PittetL02/tpi_carte_electronique_didactique_pittetl02/rpt/photo/Oscilloscope/Bruit_0xA5/00a5d249-485c-46f5-a8fa-445c6b23f5df.jpg

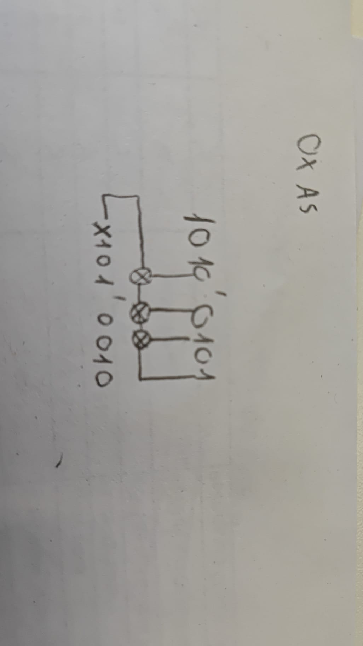
rpt/photo/Oscilloscope/Bruit_0xA5/00a5d249-485c-46f5-a8fa-445c6b23f5df.jpg
