PittetL02/tpi_carte_electronique_didactique_pittetl02/rpt/photo/PCB/V2.0.2/Monté/PCB_Vue_Top.jpg

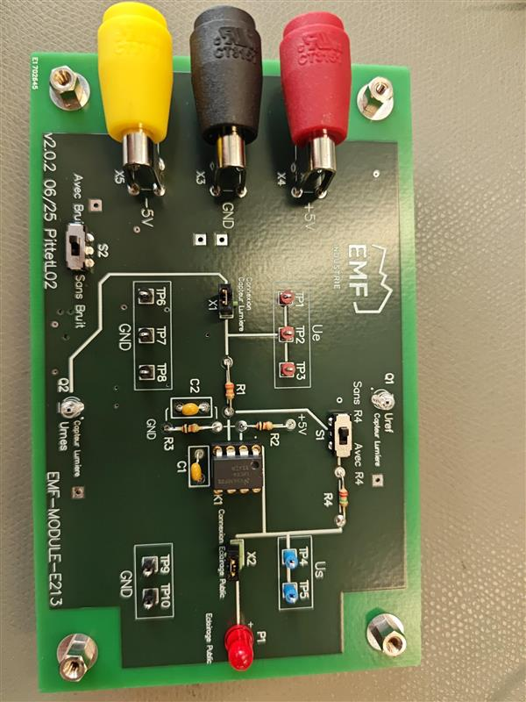
rpt/photo/PCB/V2.0.2/Monté/PCB_Vue_Top.jpg
