PittetL02/tpi_carte_electronique_didactique_pittetl02/pcb/readme.md

# Dossier "pcb"

 Contient toutes les informations nécessaires à la construction du PCB
 Ce dossier est spécialement conçu pour contenir un projet Altium.
 Tous les templates sont dans ce dossier
