PittetL02/tpi_carte_electronique_didactique_pittetl02/pcb/gerber/readme.md

# Dossier "gerber"

 Contient les derniers fichiers gerber créés.
