PittetL02/tpi_carte_electronique_didactique_pittetl02/pcb/pdf/readme.md

# Dossier "pdf"

 Contient les derniers fichiers pdf créés.
 
 example:
 
 projectname-pcb-schematic.pdf
 projectname-pcb-layout-top-implantation.pdf
 projectname-pcb-layout-top-implantation.pdf
