PittetL02/tpi_carte_electronique_didactique_pittetl02/rpt/datasheet/readme.md

# Dossier "datasheet"

 Contient tous les datasheets externes pour la création du projet.
 
 Un datasheet peut être utilisé pour du pcb, pour du fwr, pour du rpt, c'est pourquoi on place les datasheets dans ce répertoire spécifique
