PittetL02/tpi_carte_electronique_didactique_pittetl02/rpt/carte_electronique_didactique_PittetL02-rpt-development.docx

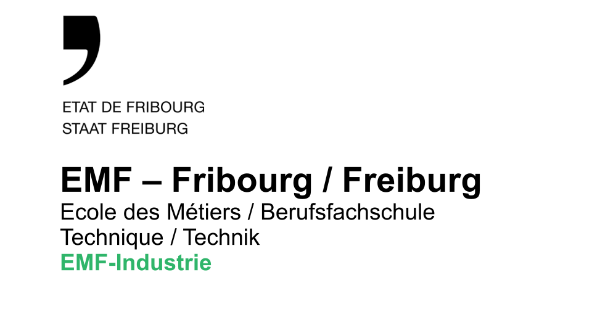
[picture p3: figure]

ELECTRONICIEN/NE CFC
ELEKTRONIKER/IN-EFZ

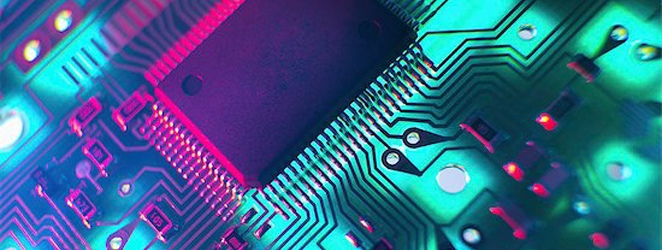
[picture p4: figure]
Le secteur de la technologie en Bourse

Carte Electronique Didactique

1.0.2

Module E213

Métier, Beruf

Pittet Loïc

2024/2025

EMF - Ecole des Metiers de Fribourg

SWITZERLAND

# Table des matières

# 1 Information

## 1.1 Objectifs du projet

Le but du projet est de réalisé un PCB qui met en valeur l’effet de l’hystérèse sur un comparateur en prenant en compte une tension d’entrée variable grâce à un capteur analogique de lumière pour pouvoir voir si l’on doit allumer une LED (éclairage public) s’il y’a trop peu de lumière. Un bruit sera généré avec un PIC.

### 1.1.1 Résumé du cahier des charges

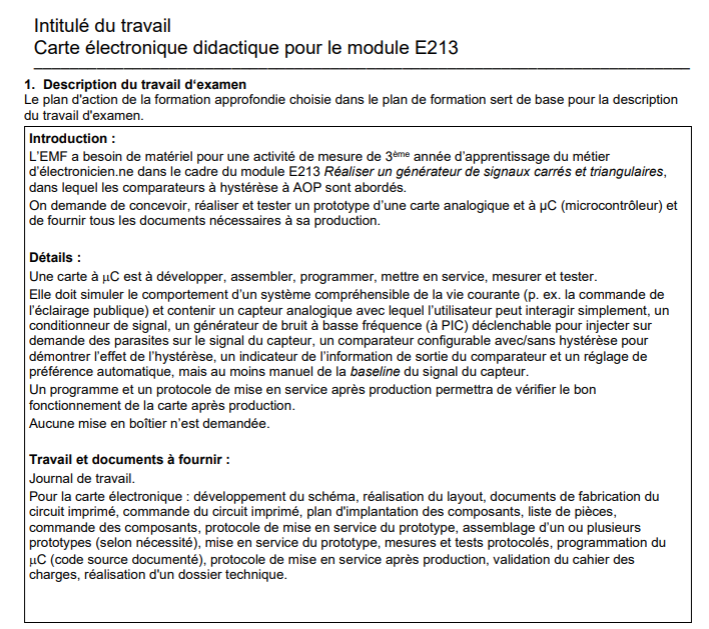
[picture p5: figure]

# 2 Planification

## 2.1 Calendrier prévisionnelle des tâches à réaliser

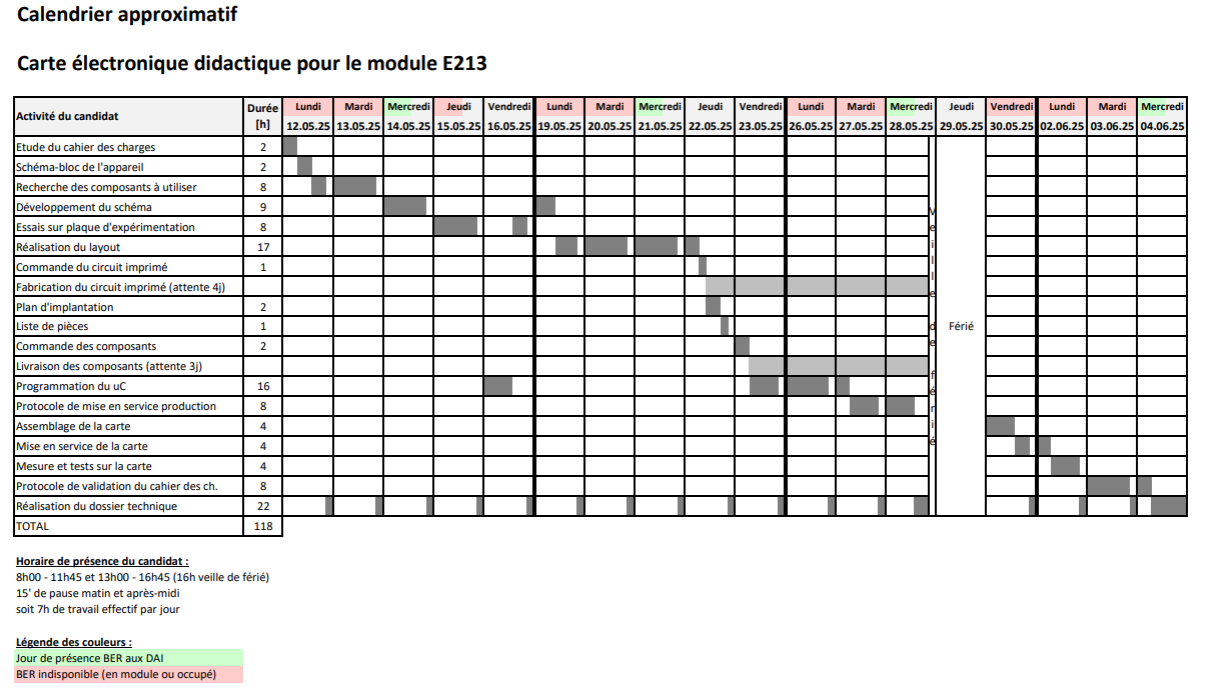
[picture p6: figure]

## 2.2 Calendrier réel des tâches réalisées

# 3 Décision

Date | Qui | Quoi | Pourquoi
13.05.2025 | Pittet | Changer de capteur de lumière. - SFH-3310_EN | Capteur actuel plus disponible sur le marché avant 18 semaines… Les LDRs sont fabriqué avec du Cadmium qui est très polluant.
14.05.2025 | Pittet | Choix du moyen de faire du Bruit avec le PIC. → Bruit numérique par pseudo-aléatoire (LSFR) | Méthode la plus simple à mettre en place sans rajouter trop de composants.
14.05.2025 | Pittet, Berset | Choix du PIC. - PIC16F15214 | Pic déjà connu dans l’entreprise et il n’a pas trop d’I/O. On a besoin que d’une seule sortie.
14.05.2025 | Berset, Pittet | Mettre un deuxième capteur de lumière | Avoir une tension de référence fixe qui ne sera jamais plus grande que celle que l’on mesure. (Moins il y’a de lumière, plus la tension baisse)
15.05.2025 | Berset, Pittet | Ajout d’un filtre passe-bas | Passer d’un signal carré en sortie du PIC en un signal plus rond après le filtre. Cela rend le scintillement plus réaliste.
16.05.2025 | Berset, Pittet | Inverser les tensions à soustraire. | Avoir une tension positive à la sortie de l’additionneur inverseur pour avoir une tension positive en entrée du comparateur.
16.05.2025 | Pittet | Changement résistance en série du capteur de lumière 6k8 → 10k | Réajustement de la résistance pour le nouveau capteur de lumière.

# 4 Réalisation

## 4.1 Schéma bloc de l'électronique à développer

Le schéma bloc nous sert à mieux comprendre l’idée de base au début d’un projet. On peut y voir directement quels sont les groupes de fonctions qui sont importants dans le fonctionnement du circuit.

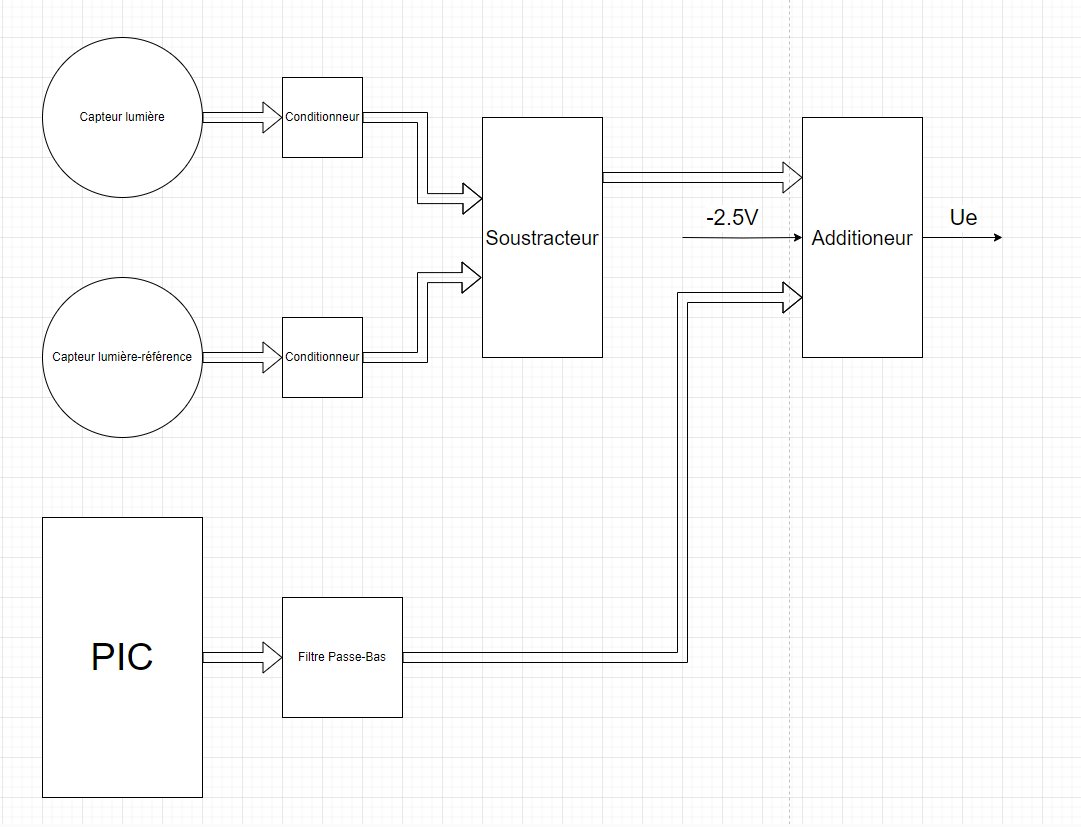
[picture p7: figure]

Le but de ce circuit est d’avoir une tension utilisable variable pour pouvoir l’utilisé comme tension comparatif à 2,5V. Pour ce faire, nous pouvons voir le conditionneur qui précède cette tension. Nous allons générer un petit bruit d’environ 20mV.

La première partie est constitué de deux capteurs de lumières (phototransistor). Un premier capteur est là pour avoir une tension de référence qui ne changera jamais (à part si un nuage vient perturber la lumière ambiante.) Cette tension sera soustraite de l’autre capteur pour que cette tension ne soit jamais positive (à voir après pourquoi). A savoir que si la lumière capté baisse, le courant baisse et en conséquence la tension aussi. Donc si l’on cache ce second capteur, la tension de référence sera de toute façon plus grande. C’est pourquoi que la tension de sortie sera négative ou nulle.

Nous allons ensuite passer cette tension de sortie du soustracteur dans un additionneur inverseur. C’est pourquoi il nous fallait une tension négative après le soustracteur pour pouvoir retrouver une tension positive à la sortie de l’additionneur. A cette tension, nous allons ajouter une composante continue de -2,5V pour pouvoir travailler autour de la tension de seuil qui est de 2.5V au lieu de travailler sur une tension pratiquement nulle.

Et pour terminer, un bruit d’environ 20mV est ajouté au signal pour pouvoir voir l’effet du bruit sur un comparateur avec et sans hystérèse. Ce bruit est généré grâce à la méthode de Bruit Numérique par Pseudo-Aléatoire (LFSR). J’utilise un PIC dans lequel j’ai codé un registre à décalage. Le bit 0,3 et 5 sont récupéré et sont passé dans des portes XOR pour avoir un nouveau bit « aléatoire » sur le 8ème bit. Ce qui nous permet d’avoir un bruit pseudo-aléatoire. Cependant, nous ne pouvons pas traiter cette tension tel quel. C’est pourquoi nous allons créer un filtre passe-bas pour avoir une tension un peu plus analogique et non numérique.

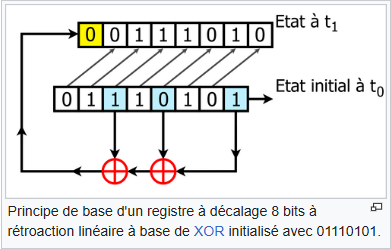
[picture p8: figure]
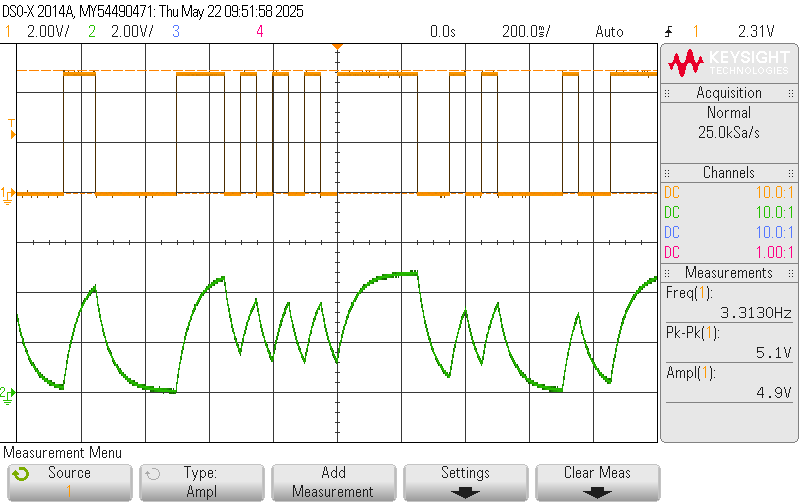
[picture p9: figure]

Le signal orange montre la sortie sur PIC. Nous pouvons observer sur le signal vert la tension filtrée en passe-bas.

Après que ces trois tensions sont additionnées, nous pouvons la traiter dans une entrée de notre comparateur. Nous allons comparer cette tension d’entrée variable à une tension de seuil fixe de 2,5V. Voilà pourquoi nous avions ajouté un offset de 2.5V auparavant.

### 4.1.1 Schéma bloc de l'électronique à développer 2

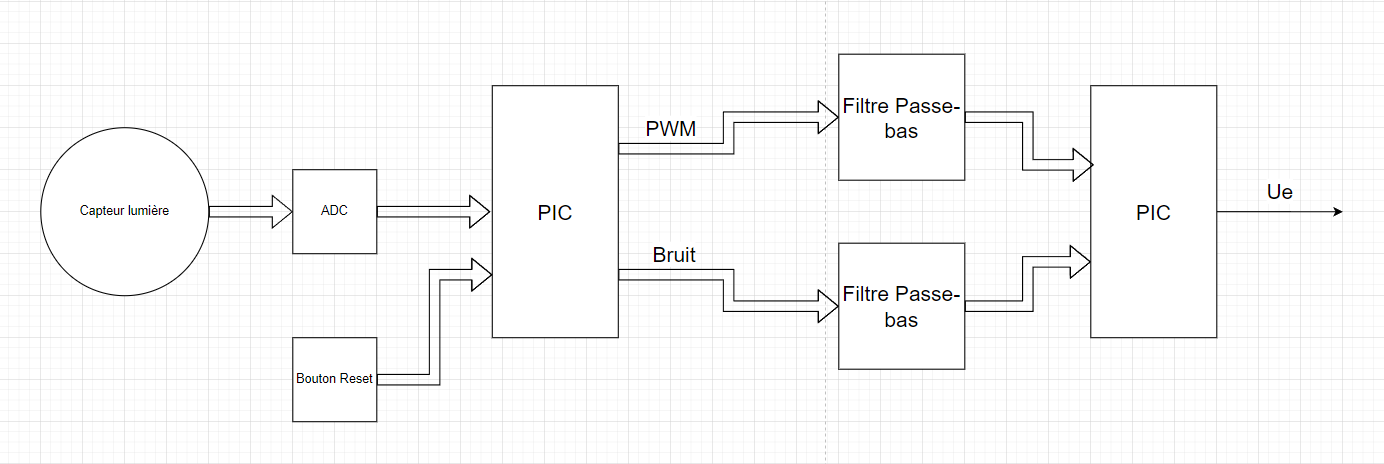
[picture p10: figure]

Cette proposition a été jugé trop compliqué à gérer la partie PWM.

Le but était de reset le programme avec un bouton lorsque la lumière ambiante change. Mais dans un atelier, il y’a du mouvement, des zones d’ombres et s’en parler des perturbations externes tels que les nuages, un coucher de soleil, une lampe…

Cette version avait été imaginer pour que le PIC s’occupe de tout en interne.

### 4.1.2 Schéma bloc de l'électronique à développer 3

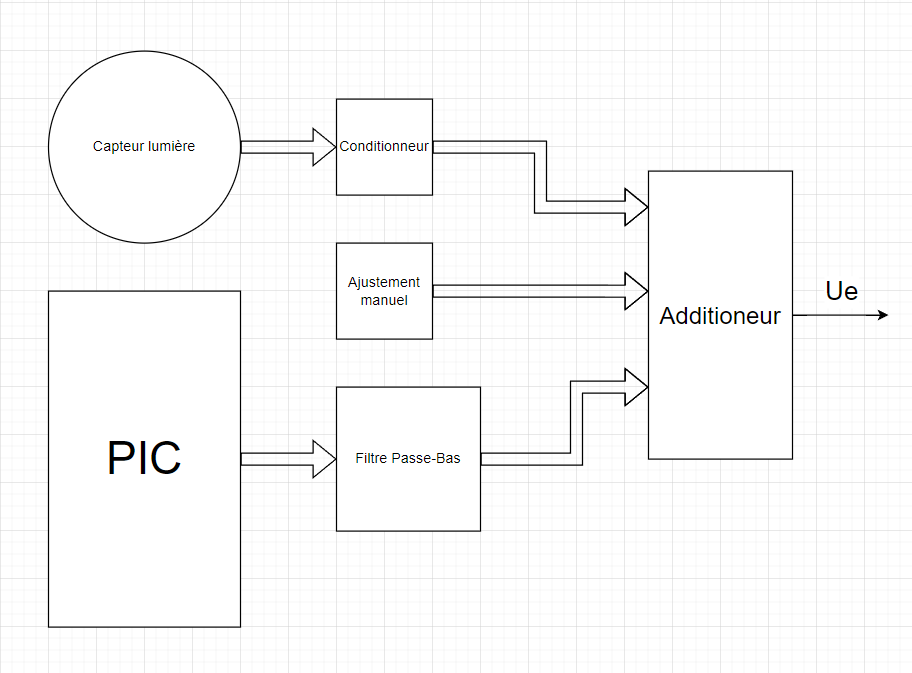
[picture p11: figure]

Solution abordable mais pas très pratique puisqu’à chaque fois qu’un évènement vient perturber la lumière, il faut réajuster la tension (de référence) avec un trimmer (donc manuellement) par exemple la tension de la lumière actuelle. Par exemple lorsqu’un nuage passe devant le soleil, cela va biaiser les mesures. Pareil si quelqu’un éteint la lumière…

Cette solution est un entre deux entre la version PWM et la version choisie.

## 4.2 Schématique, Dimensionnement & simulation

### 4.2.1 Schématique globale

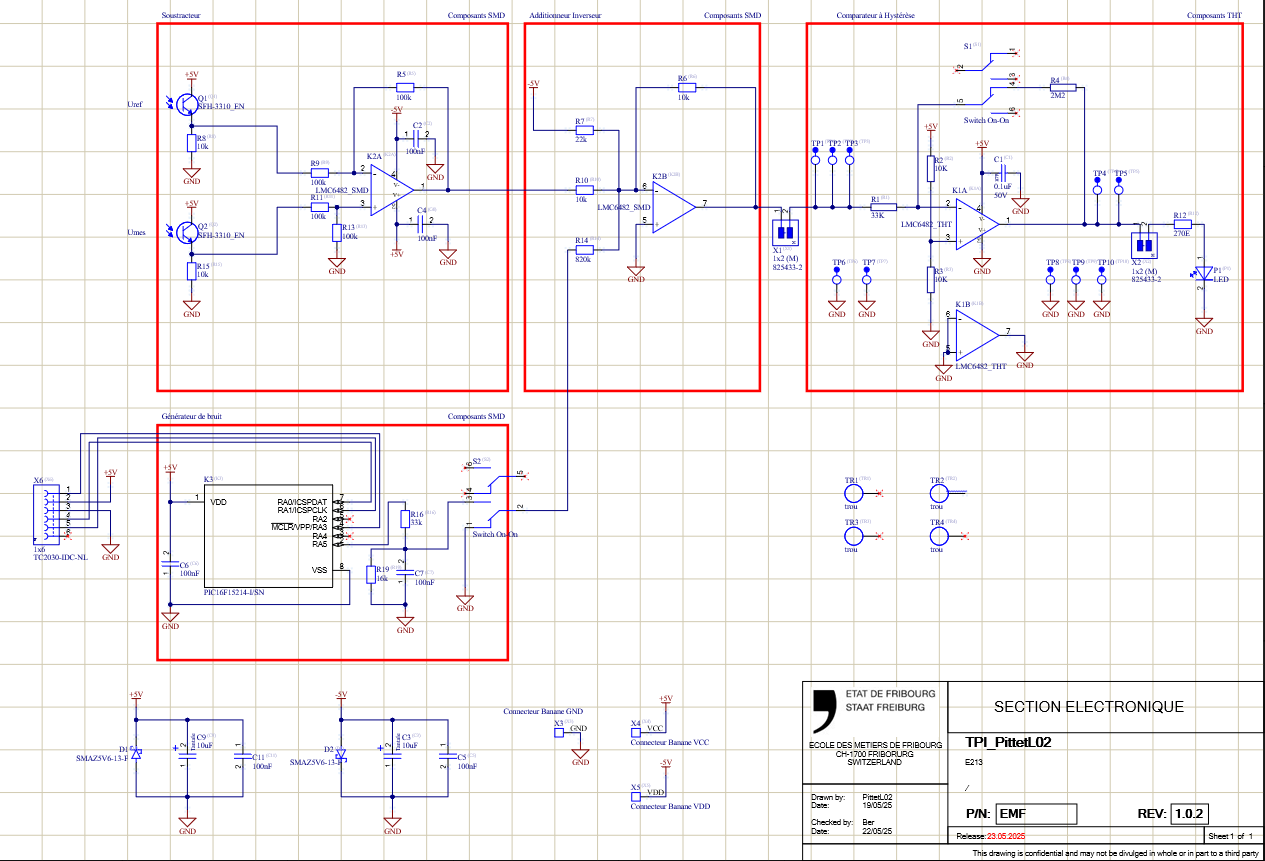
[picture p12: figure]

#### 4.2.1.1 Schématique Soustracteur

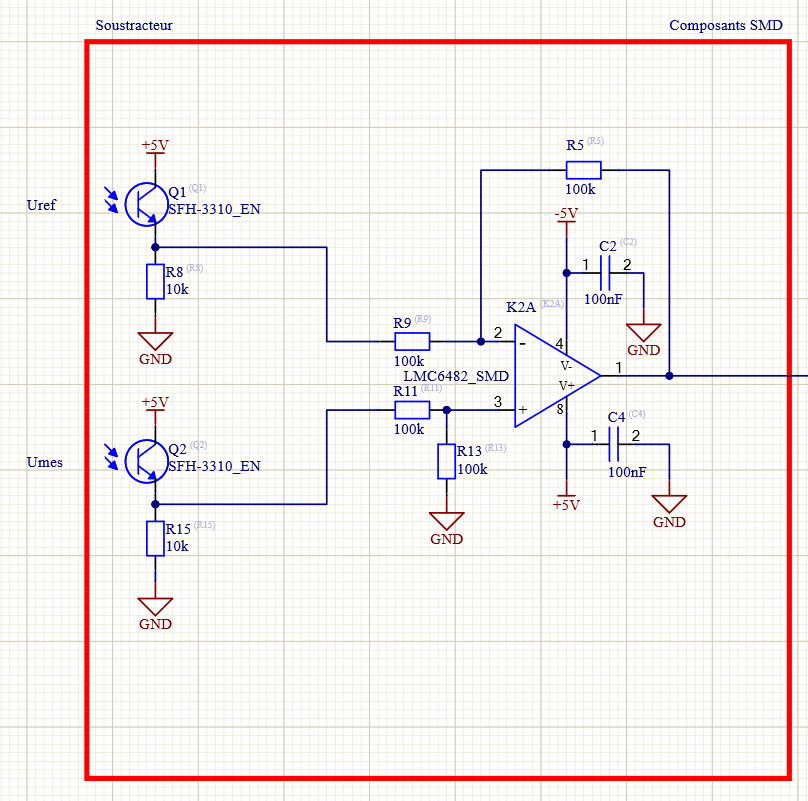
[picture p13: figure]

Voici la première partie de notre schéma. On peut observer que l’on soustrait une tension de référence « fixe » à une tension mesurable (Umes).

Q1 et Q2 sont deux phototransistors qui mesurent l’intensité lumineuse.

Q1 est fixe, c’est-à-dire que l’on ne va jamais modifier la lumière qu’il capte.

Q2 est variable, c’est-à-dire que si l’on vient cacher le capteur de la lumière, le courant va baisser et donc la tension aussi.

On n’a pas besoin d’amplifier le signal donc j’ai dimensionné un gain de 1.

La tension de sortie du soustracteur sera toujours négative ou égal à 0V. Comme on vient que cacher Q2 et que l’on ne va jamais venir ajouter de la lumière dessus, alors la tension de sortie ne sera jamais positive. (voir plus bas avec simulation TINA)

#### 4.2.1.2 Schématique Additionneur

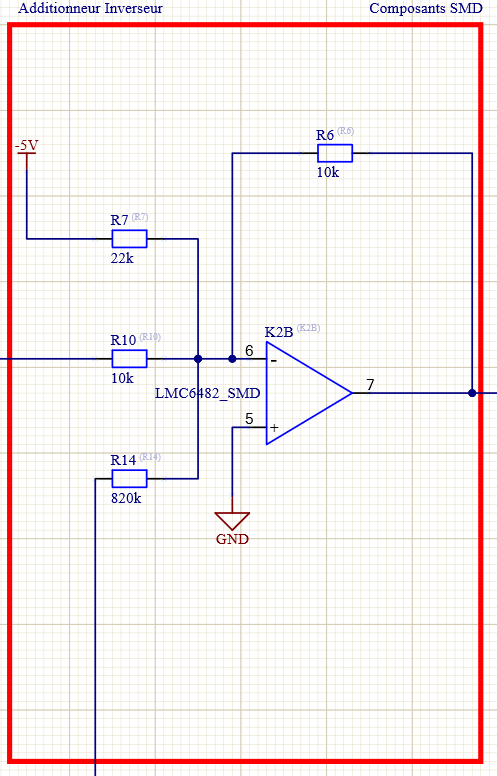
[picture p14: figure]

Voici la deuxième partie du notre schéma. On peut observer que l’on additionne trois tensions. Nous avons la tension de sortie du soustracteur sur R10, une composante continue de -2,5V sur R7 et une dernière tension de 20mV qui est une simulation de bruit.

Le montage est un additionneur inverseur. Voilà pourquoi on voulait une tension négative en sortie du soustracteur. On peut avoir une tension minimale de -2,5V et maximale de 0V sur R10 avec un gain de 1.

Pour générer un offset de 2,5V pour pouvoir travailler autour de la tension de seuil du comparateur qui est de 2.5V, on va additionner une composante continue de -2.5V avec un gain de -0.5V/V (-R6/R7).

La dernière tension additionnée est une tension d’environ 1.6V sur R14 avec un gain de 12mV/V pour avoir une tension de bruit de 20mV (-R6/R14). Cette tension est générée par un PIC (détaillé plus bas).

Nous allons retrouver une tension positive ou égal à 0V en sortie de l’additionneur.

#### 4.2.1.3 Schématique Générateur de bruit

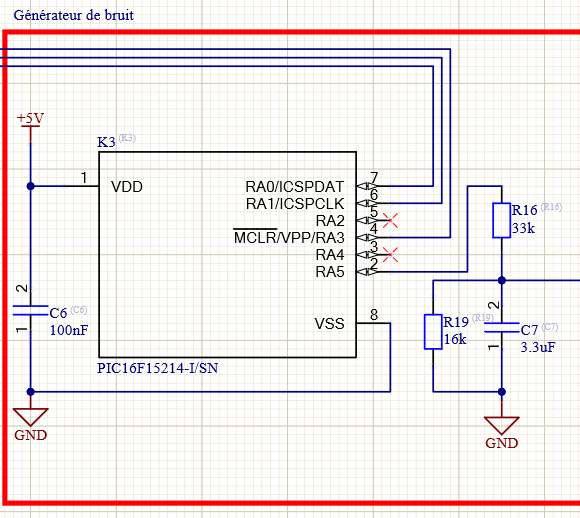
[picture p15: figure]

Voici une partie importante de la schématique. Puisque c’est grâce à ce bruit que toute l’application ait du sens.

Le PIC génère une tension numérique « aléatoire » grâce à un registre à décalage de 8 bits. On ressort le bit 0,3 et 5 que l’on passe dans des portes XOR et l’on remet ce bit en entrée du registre à décalage. Avec ce procédé, on obtient une tension numérique pseudo-aléatoire. Ce qui nous permet de dire que cela est du bruit après avoir filtré cette tension avec C7 pour la rendre analogique.

Le diviseur de tension nous permet de réduire la tension pour éviter d’avoir une résistance R14 (additionneur) trop élevé. On a un peu près une tension de 1.6V sur R14 (5V x (R19/R19+R16)).

#### 4.2.1.4 Schématique Comparateur à Hystérèse

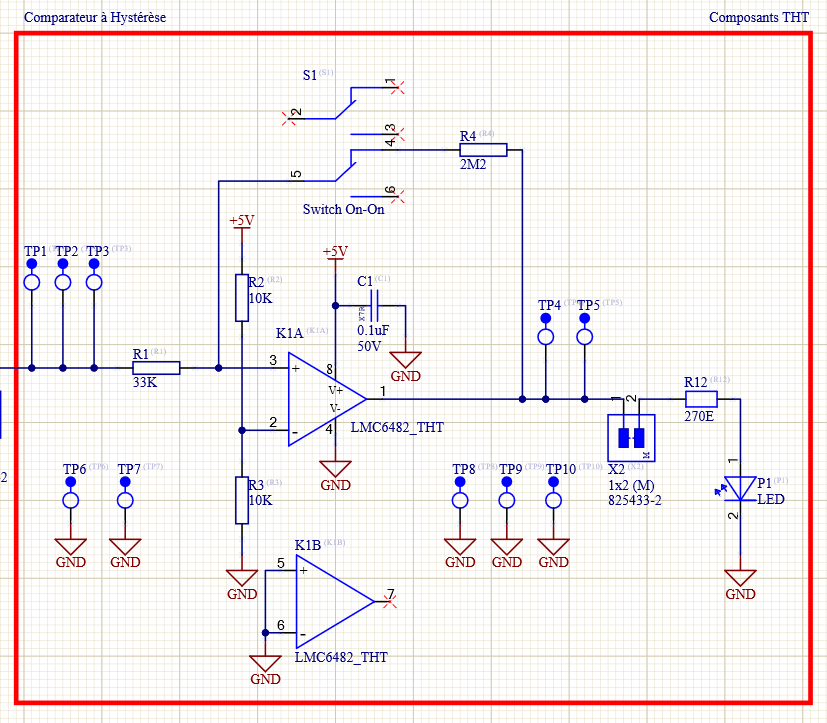
[picture p16: figure]

Cette dernière partie est la partie principale du schéma. Après avoir conditionné le signal avant, on peut enfin venir utiliser cette tension.

On va venir comparer la tension variable conditionné auparavant à une tension fixe de 2.5V (diviseur de tension entre R2 et R3 qui sont identiques).

On a le choix de connecté ou non la résistance R4 (hystérèse) pour pouvoir voir l’effet de celle-ci.

Lorsque la tension d’entrée est plus grande que 2.5V, alors le comparateur va sortir un 1 logique et ainsi 5V en sortie.

Lorsque la tension d’entrée est plus petite que 2.5V, alors le comparateur va sortir un 0 logique et donc 0V.

Pour pouvoir voir l’effet du bruit et de l’hystérèse, on a branché une LED en sortie du comparateur pour pouvoir bien voire quand la LED scintille ou non.

### 4.2.2 Dimensionnement

Pour une tension de 2.5V à lumière ambiante, il faut calculer la résistance à partir d’une autre choisi « aléatoirement ». Dans notre cas, nous mesurons la tensions (à la lumière ambiante) sur une résistance de 6.8kOhms. Nous pouvons ainsi déterminer la résistance pour 2.5V.

Dimensionnement Résistance série du capteur de lumière :

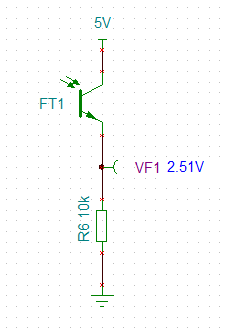
[picture p17: figure]
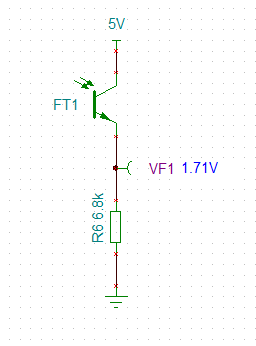
[picture p18: figure]
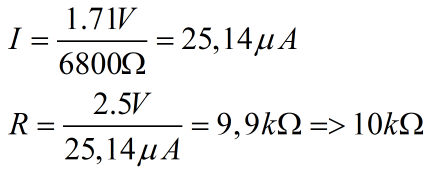
[picture p19: figure]
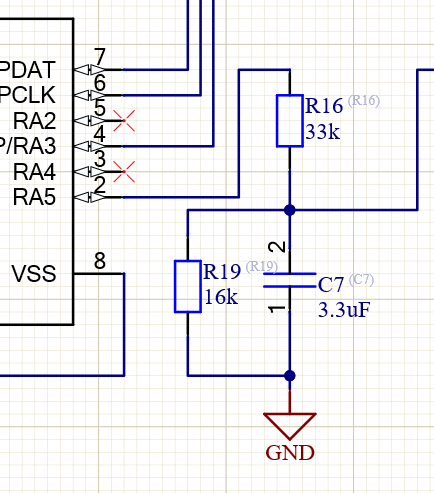
[picture p20: figure]

Dimensionnement Résistance de Bruit :

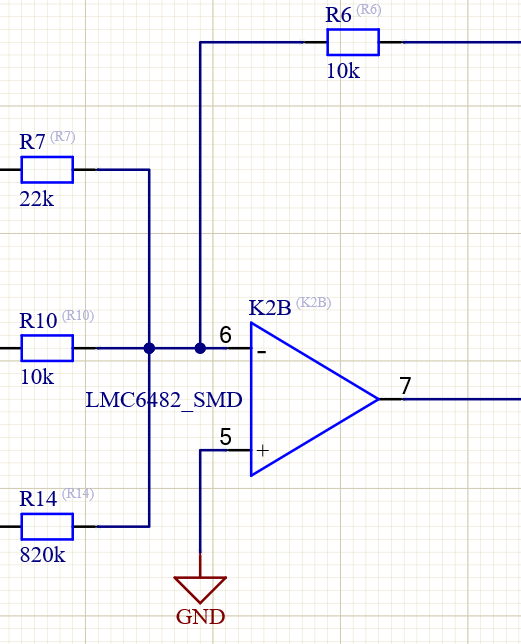
[picture p21: figure]
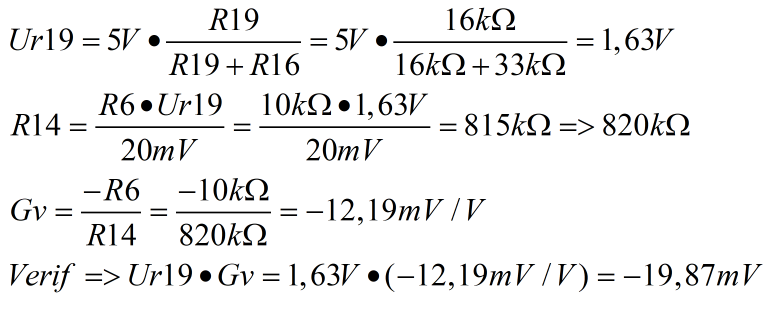
[picture p22: figure]

Le but de ce diviseur de tension entre R16 et R19 est d’abaisser la tension pour ensuite pouvoir abaisser la valeur de R14 et éviter qu’elle soit trop grande.

Dimensionnement Condensateur du filtre passe-bas :

Pour une fréquence de coupure d’environ 50Hz et une résistance de 50kOhms mesuré sur plaque d’essais (Potentiomètre en série avec le condo pour pouvoir ajuster au mieux ) :

Après test, la constante de temps est jugée trop courte.

→x10 sur C →680nF

Il faut réajuster le condensateur pour garder la même constance de temps avec les nouvelles résistances.

Pour le soustracteur, nous avons besoin d’un gain de 1V/V

C’est pourquoi nous avons les mêmes valeurs de résistances pour R5,R9,R11 et R13.

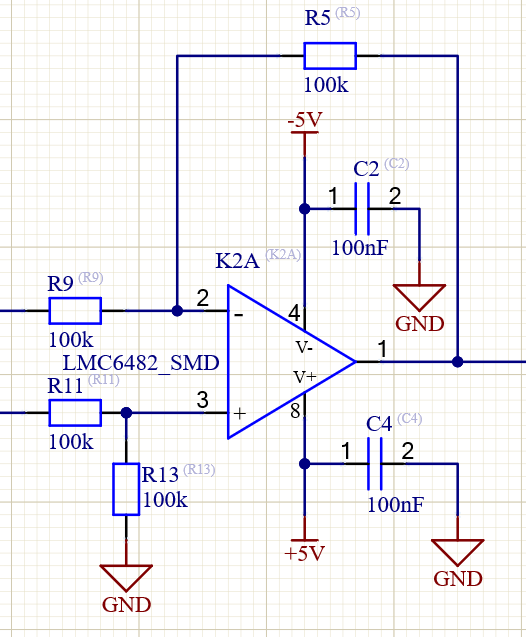
[picture p23: figure]

#### 4.2.2.1 Estimation du courant de consommation du système

A lumière ambiante :

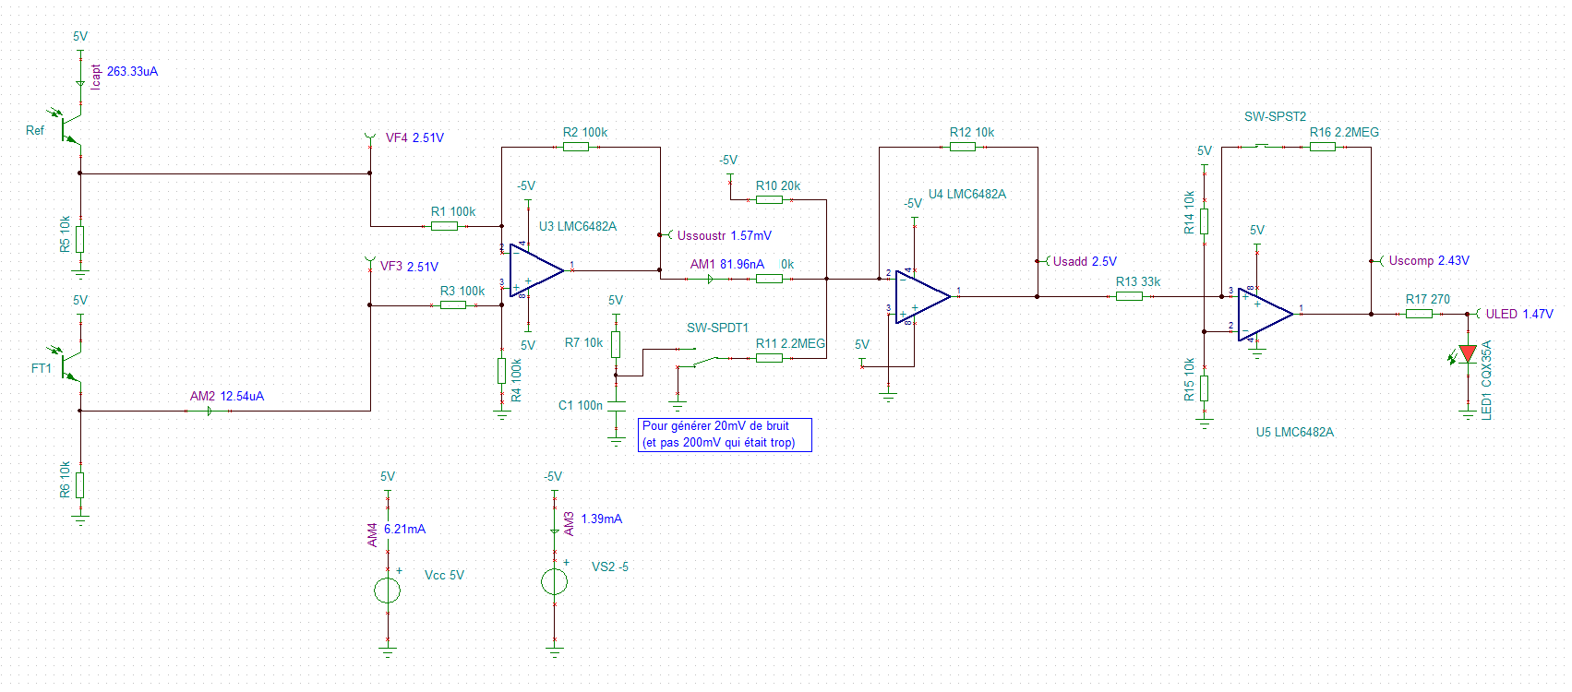
[picture p24: figure]

A lumière maximale :

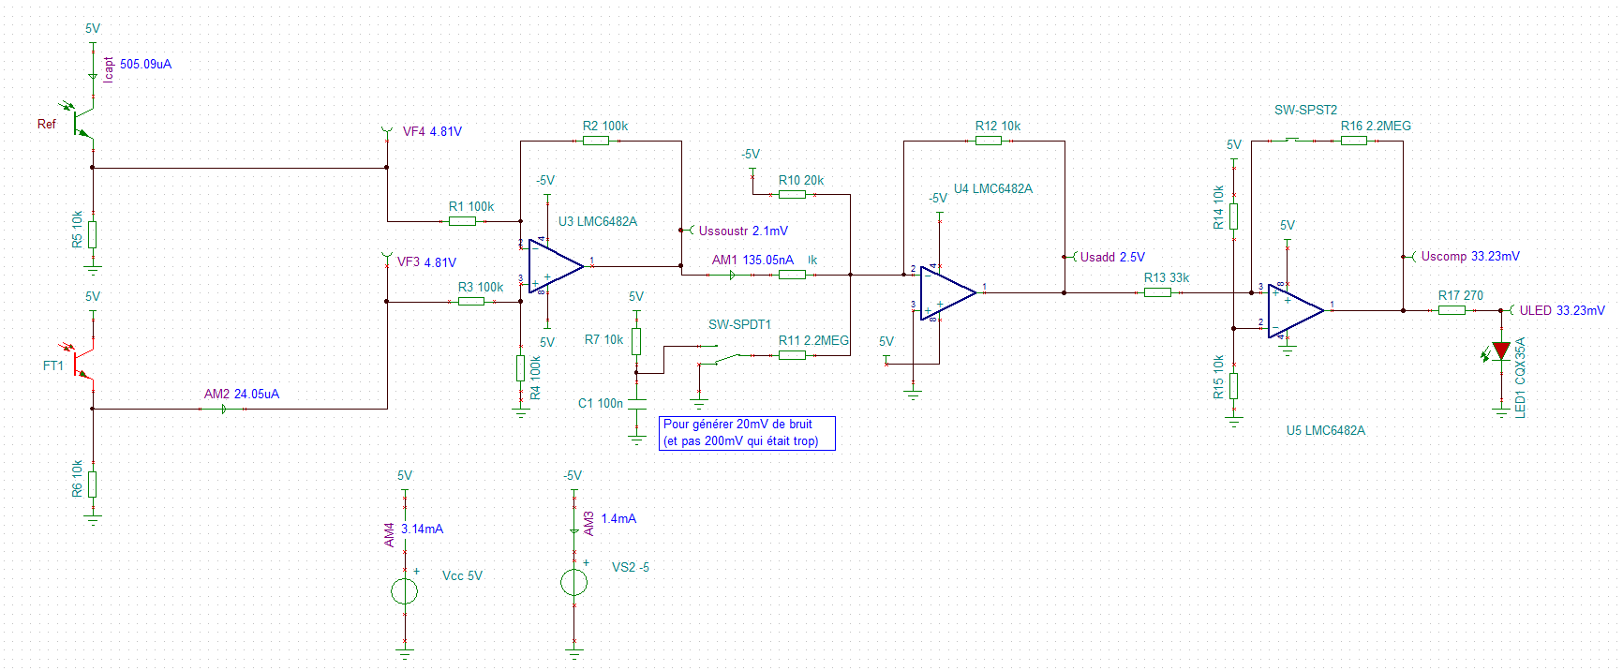
[picture p25: figure]

A lumière minimale :

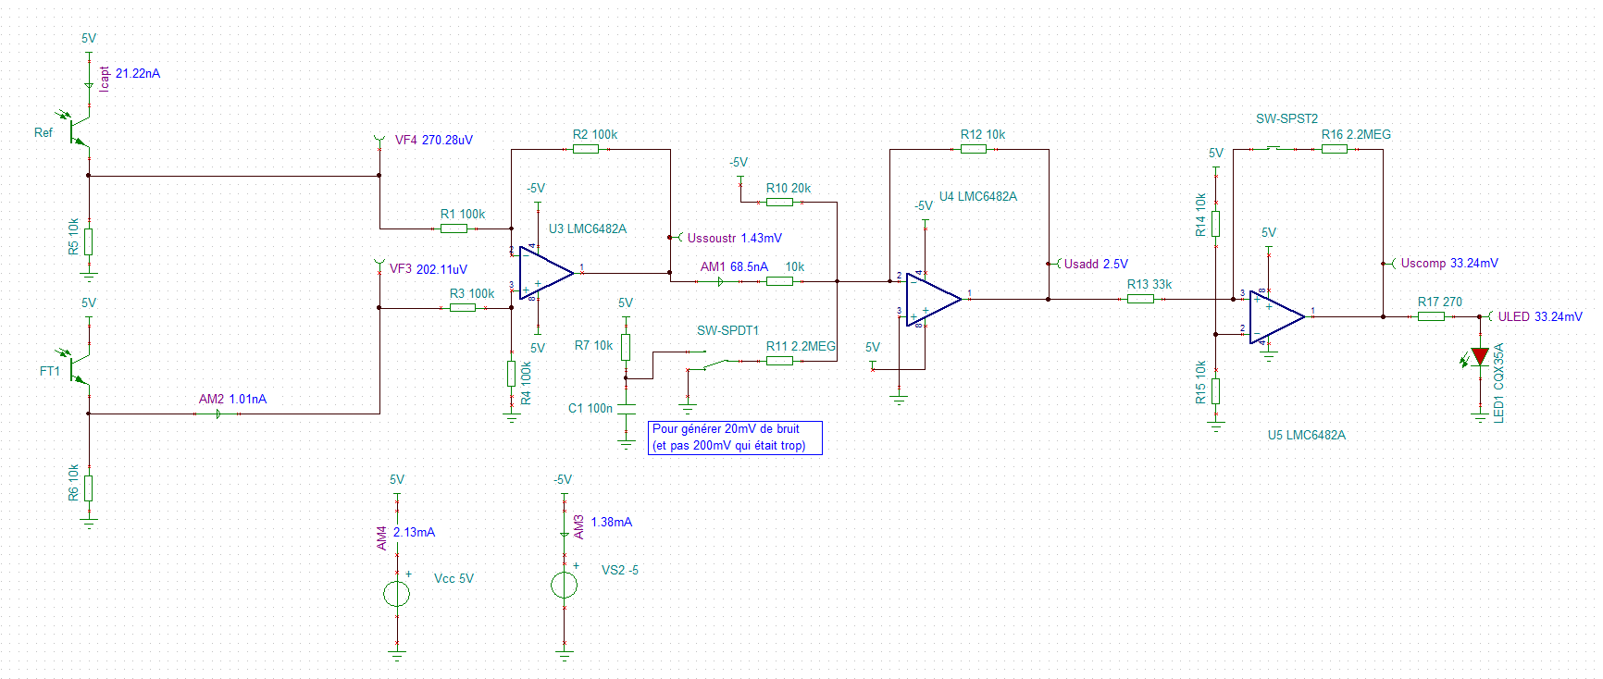
[picture p26: figure]

## 4.3 Rédaction du protocole de mise en service du prototype

### 4.3.1 Protocole de mise en service

Etape | Quoi faire | Valeur attendue | Valeur mesurée | Erreur | Validée | Mes. Ref.
1 | Implanter les connecteurs d’alimentations Mesurer les tensions d’alimentations aux différents endroits dans le pcb (connexions d’alimentation sur ICs, PIC) … | - +5V -5V | - | - | | -
2 | Implanter les condensateurs de découplages et la diode de protection Mesurer les tensions d’alimentations | +5V -5V | | …%
3 | Implanter le bloc Soustracteur Mesurer la tension d’entrée et de sortie du bloc | Ue = ~2.5V Us =~0V
4 | Implanter le bloc Additionneur Inverseur Mesurer la tension d’entrée et de sortie du bloc | - Ue = ~0V Us = ~2,5V | - | - | | -
5 | Implanter le bloc Générateur de bruit Mesurer la tension de sortie du bloc | Us = ~1,6V
6 | Implanter le bloc Comparateur à Hystérèse Mesurer la tension d’entrée et de sortie du bloc Mesurer la tension sur la PIN 2 | Ue = ~2.5V Us = ~0V ~2.5V
7 | Mesure tension d’entrée et de sortie du comparateur avec Q2 complètement dans le noir | Ue = ~5V Us = ~5V
8 | Mesure tension d’entrée et de sortie du comparateur avec Q2 un peu caché | 5V > Ue > 2.5V Us = ~5V
9 | Mesure du courant d’entrée à lumière ambiante | Ie+ = ~6.2mA Ie- = ~-1.39mA

### 4.3.2 Mesure1

#### 4.3.2.1 But de la mesure

#### 4.3.2.2 Schéma de mesure

#### 4.3.2.3 Liste des composants

#### 4.3.2.4 Liste des instruments et leurs réglages

#### 4.3.2.5 Tableaux des valeurs mesurées

### 4.3.3 Mesure2

#### 4.3.3.1 But de la mesure

#### 4.3.3.2 Schéma de mesure

#### 4.3.3.3 Liste des composants

#### 4.3.3.4 Liste des instruments et leurs réglages

#### 4.3.3.5 Tableaux des valeurs mesurées

## 4.4 Liste de matériel

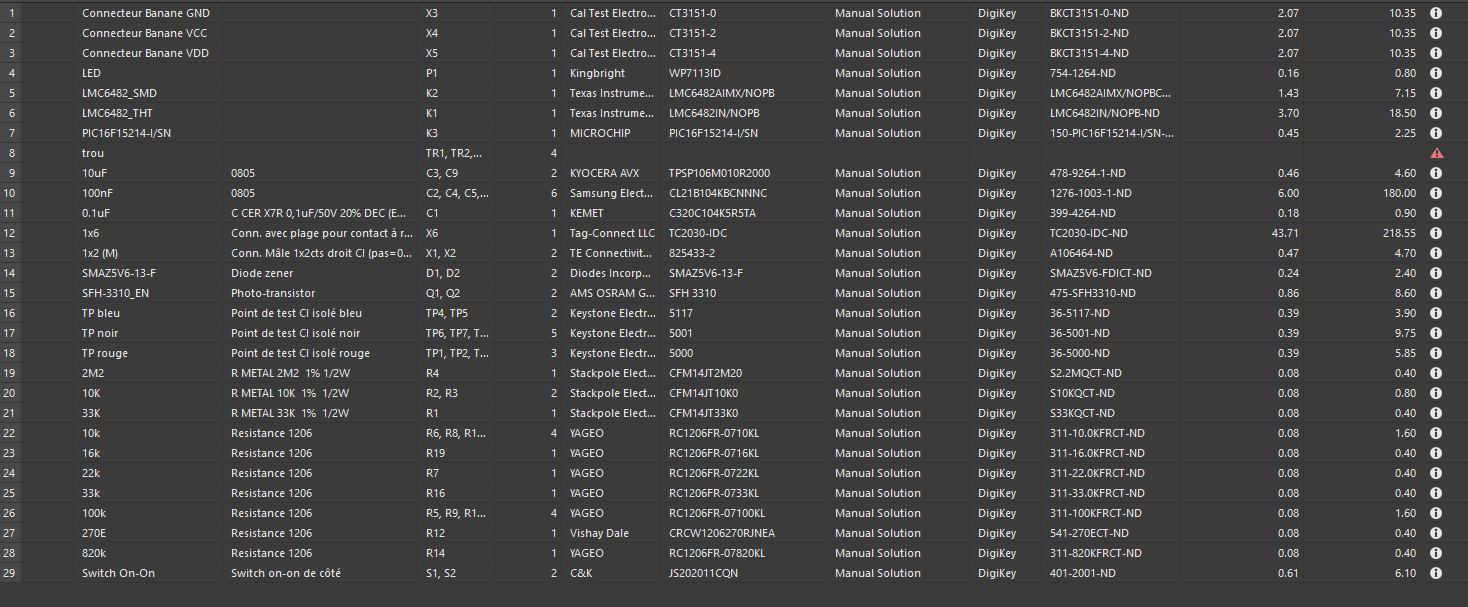
[picture p27: figure]

## 4.5 Layout

### 4.5.1 Contraintes (Rules Check)

J’ai essayé de mettre une clearance la plus grande possible. Malheureusement, comme il y’a des ICs sur le PCB, il n’est pas possible de faire plus grand que 0.2mm sinon les pads de l’IC vont crier lors du DRC.

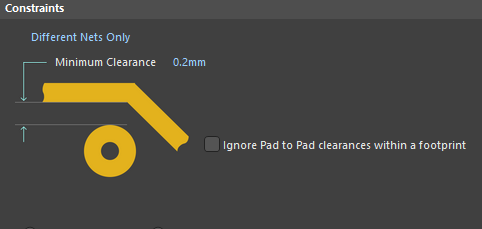
[picture p28: figure]
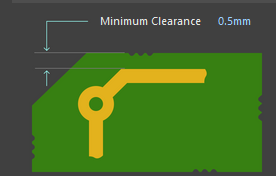
[picture p29: figure]

J’ai défini une BoardOutlineClearance de 0.5mm pour éviter de positionner des composants trop proches du bord. C’est une sécurité pour éviter d’avoir des dommages dû à la fraise de découpage.

#### 4.5.1.1 Largeurs des pistes de cuivre

Pour la largeur de piste, j’ai mis une largeur de piste assez grande (0.762mm) pour les pistes d’alimentation tel que le -5V et le GND. Pour le reste des pistes, elles ont une largeur de 0.4mm. Ces pistes sont normalement assez grandes pour pouvoir accueillir au maximum 10mA.

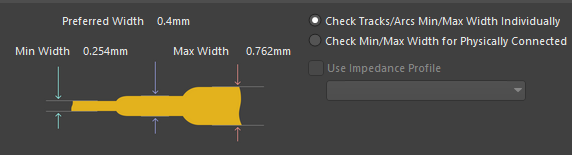
[picture p30: figure]

#### 4.5.1.2 Diamètres des vias

Comme nous avons des pistes maximales de 0.762mm, on ne peut pas mettre de vias de diamètre plus petit. C’est pourquoi j’ai décidé de mettre des vias de diamètre 1mm pour avoir de bonnes connexions. Sur Altium, les vias sont configuré de base avec des freins thermiques. Je l’ai enlevé pour avoir une meilleure connexion.

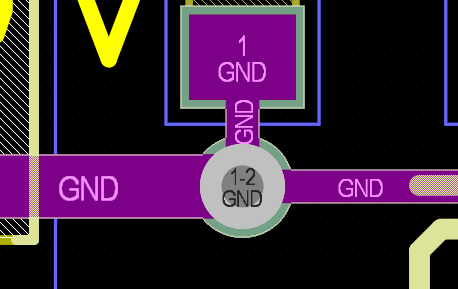
[picture p31: figure]

### 4.5.2 Empreintes spécifiques

#### 4.5.2.1 Connecteur d’alimentation

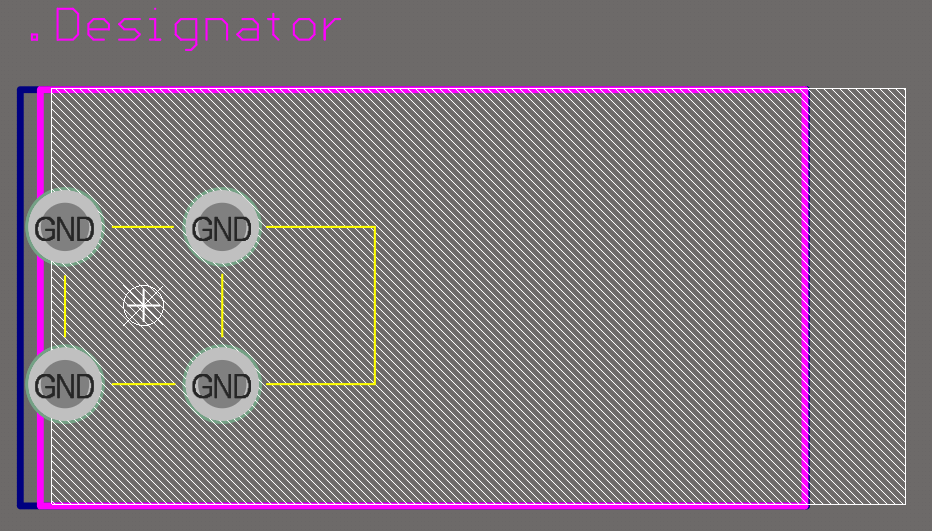
[picture p32: figure]
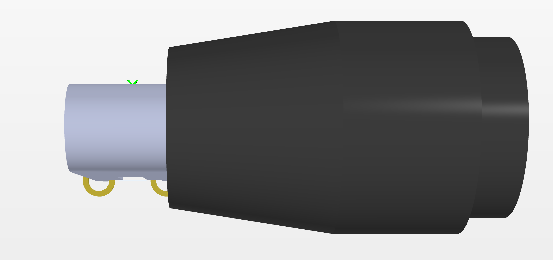
[picture p33: figure]

Cette empreinte est un connecteur banane pour pouvoir facilement brancher les alimentations. Il y’en 1 en noir pour le GND, un rouge pour le +5V et un jaune pour le -5V.

#### 4.5.2.2 AOP LMC6482_SMD/THT

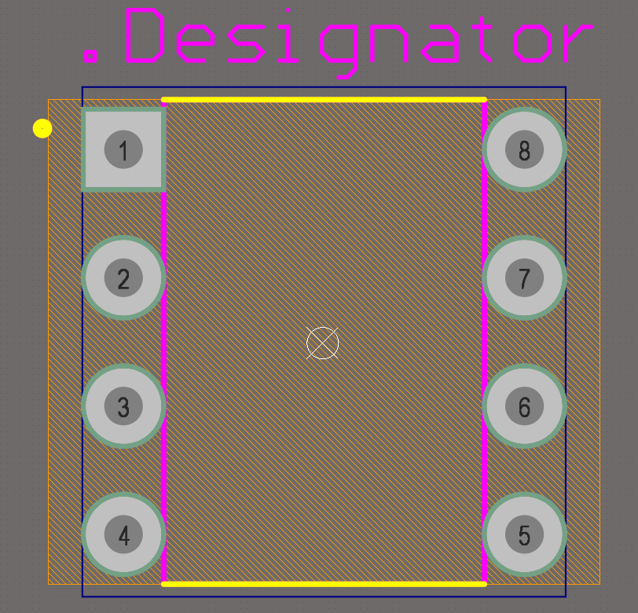
[picture p34: figure]
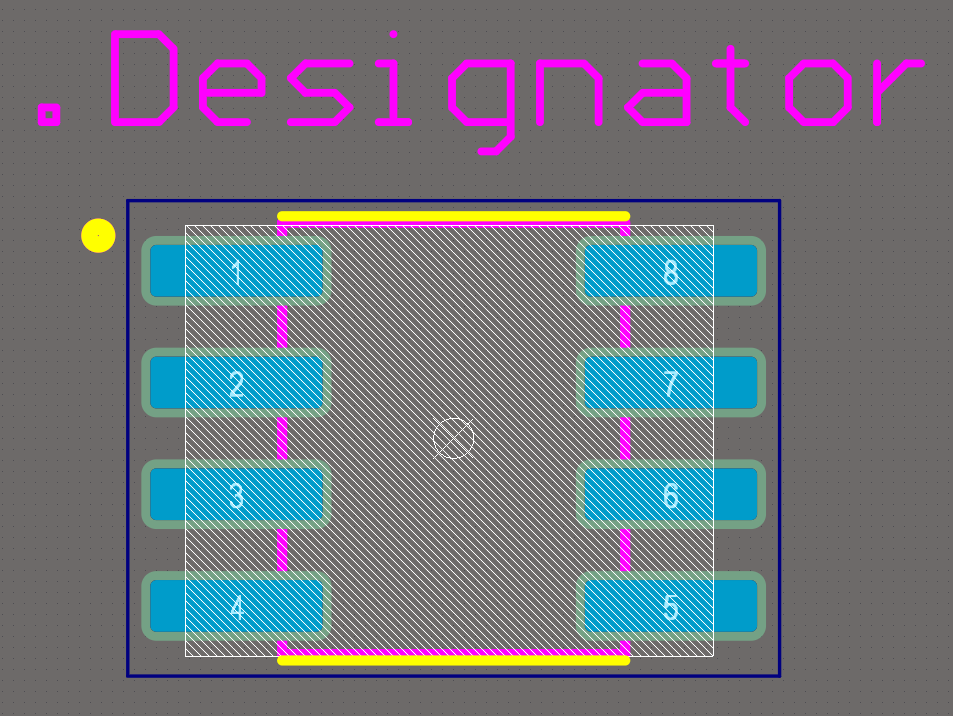
[picture p35: figure]

Dans le projet, nous utilisons plusieurs AOP que ce soit comme soustracteur, additionneur ou encore comme comparateur, cela en fait 3. Nous avons donc choisi d’utiliser 2 ICs dual. Le comparateur est sur la version THT pour que les apprentis puissent le manipuler / le voir sur le TOP. Et le soustracteur ainsi que l’additionneur sont sur une version SMD qui sera présente sur le BOT car ceci représente le conditionneur, chose que les apprentis n’ont pas besoin de voir sur la couche TOP.

#### 4.5.2.3 Phototransistor : SFH-3310

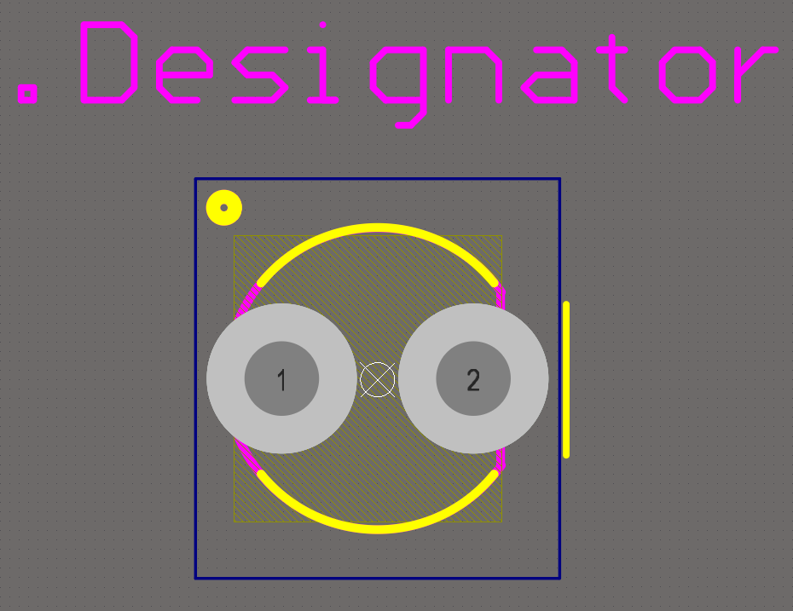
[picture p36: figure]
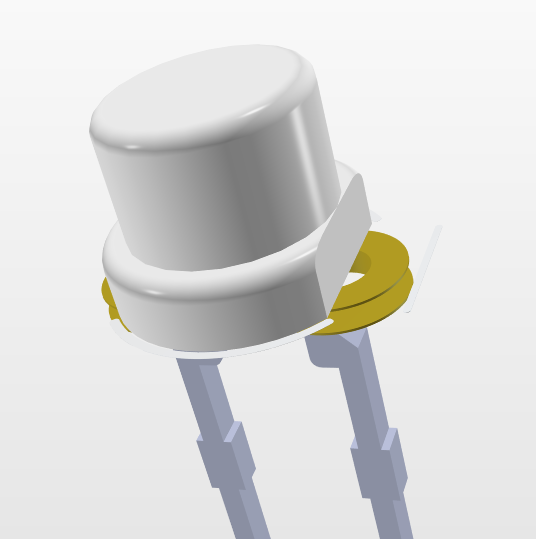
[picture p37: figure]

Voici l’empreinte du capteur de lumière (phototransistor). Il faut faire attention à la polarité.

#### 4.5.2.4 Microcontrôleur

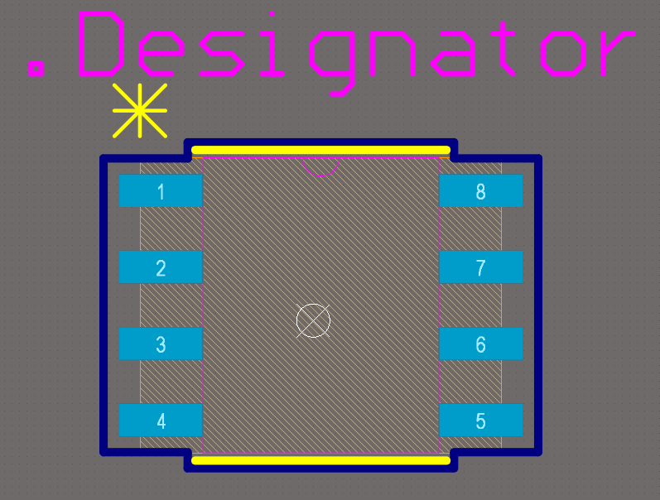
[picture p38: figure]
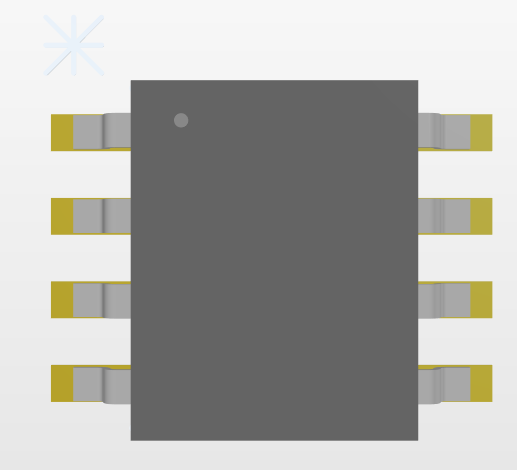
[picture p39: figure]
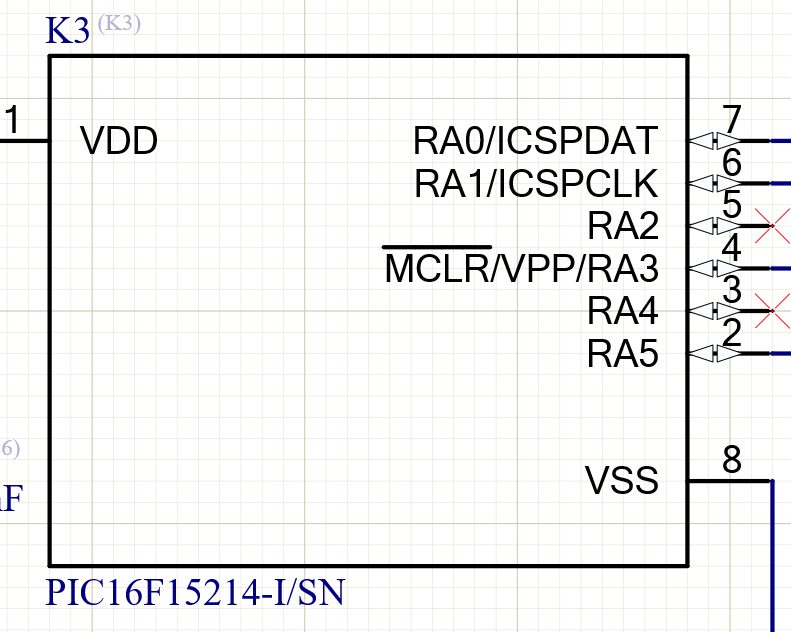
[picture p40: figure]

Nous utilisons le PIC 16F15214-I/SN parce que nous avons très peu d’I/O (un seul). Donc pas nécessaire de prendre un PIC trop grand inutilement. Sur le PIC, nous avons les connexions pour le connecteur de programmation soit : ICSPDAT sur RA0 (Pin 7), ICSPCLK sur RA1 (Pin 6), MCLR sur RA3 (pin 4) et la sortie du PIC sur RA5(Pin 2). Un condensateur de découplage(100nF) a été connecté aux bornes d’alimentations de celui-ci pour lisser la tension et éviter des pics de tensions et donc des surtensions. Nous utilisons ce PIC précisément parce-que nous l’avons déjà employé à l’EMF donc le PIC est connu et déjà testé.

#### 4.5.2.5 Connecteur de programmation

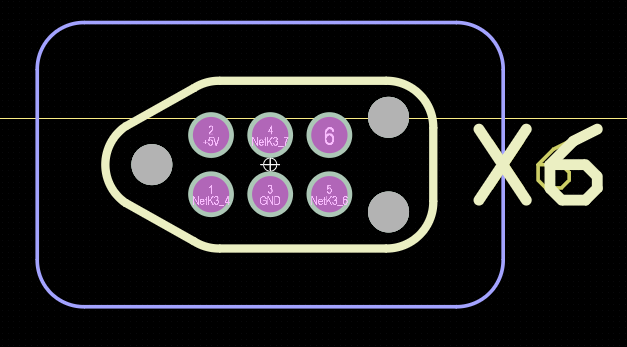
[picture p41: figure]
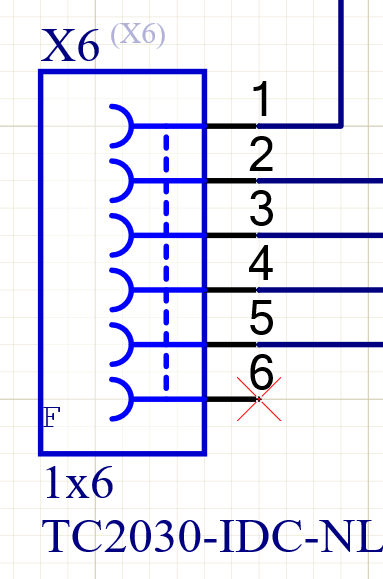
[picture p42: figure]

Ceci est le connecteur de programmation. C’est un connecteur TagConnect assez utile puisqu’après que la programmation ait été implémenter, aucune contrainte mécanique peut venir perturber le PCB. Seul bémol, il faut acheter un câble spécial qui coûte assez cher…

## 4.6 Firmware

uint8_t lfsr = 0xAC; // Seed non nul

void main(void)

{

InitPic();

while (1)

{

uint8_t out = lfsr_next();

LATAbits.LATA0 = out; // Écrit sur RA0

__delay_ms(50); // Ajuster selon le besoin

}

}

uint8_t lfsr_next(void)

{

uint8_t bit = ((lfsr >> 7) ^ (lfsr >> 5) ^ (lfsr >> 4) ^ (lfsr >> 3)) & 1;

lfsr = (lfsr << 1) | bit;

return lfsr & 1; // Renvoie le LSB

}

## 4.7 Phase de production en série

### 4.7.1 Rédaction du protocole de mise en service de post-production

### 4.7.2 Rédaction du mode d’emploi utilisateur

## 4.8 Liste des outils utilisés et leur version

Oscilloscope KEYSIGHT InfiniiVision 2014A EMF-INDU-PHIE-0074

Alimentation DC xantrex XPL-30-2T TRIPLE DC Power Supply EMF-INDU-PHIE-0371

Générateur de fonction Agilent 33250A EMF-INDU-PHIE-0006

Multi-mètre AMPRODE 34XR-A 19100479A

PIC KIT 4 MICROCHIP 10-10094-R1

# 5 Contrôle

## 5.1 Validation ERC

## 5.2 Validation DRC

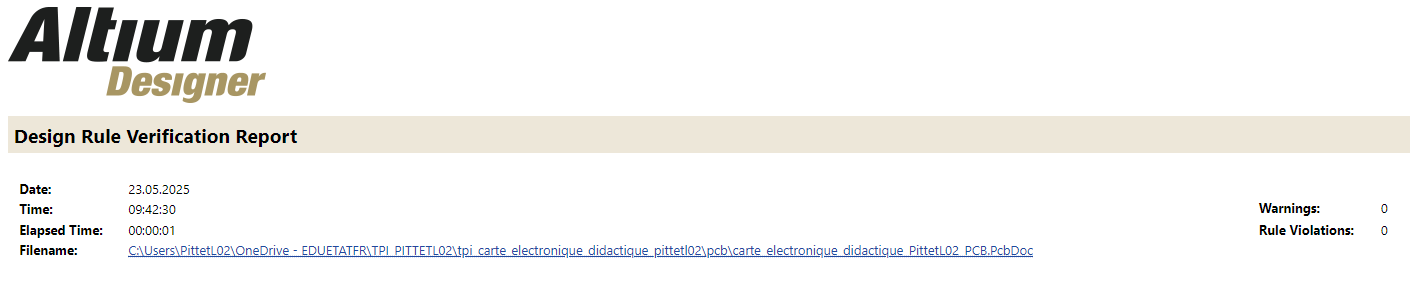
[picture p43: figure]

## 5.3 Validation Eurocircuits

## 5.4 Validation par la mise en service du prototype

# 6 Evaluation

## 6.1 Etat du projet

Fonctionnel

## 6.2 Liste des modifications pour la prochaine version

### 6.2.1 AOP Comparateur

Le comparateur inverseur a été routé à l’envers et est donc devenu un AOP inverseur. Il a donc fallu donc couper les pistes et tirer des fils pour inverser les connexions. Les pins d’alimentations sont donc aussi inversés. Il a fallu inverser ces pins en coupant la PIN du comparateur et tirer des fils pour refaire la connexion correcte.

J’ai aussi mis la sortie du deuxième comparateur à la masse. Ce qui est une grosse erreur. L’AOP va chercher à sortir une tension sur cette sortie, ce que l’on ne veut pas. Il a fallu couper la pin 7 du comparateur.

Ces erreurs ont déjà été corrigées et une nouvelle version des gerbers a déjà été généré.

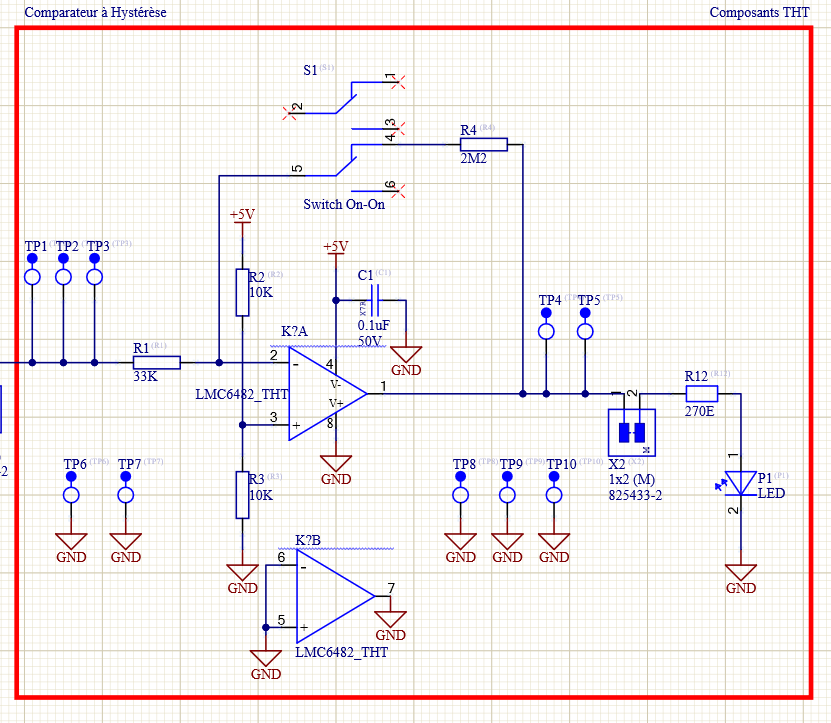
[picture p44: figure]
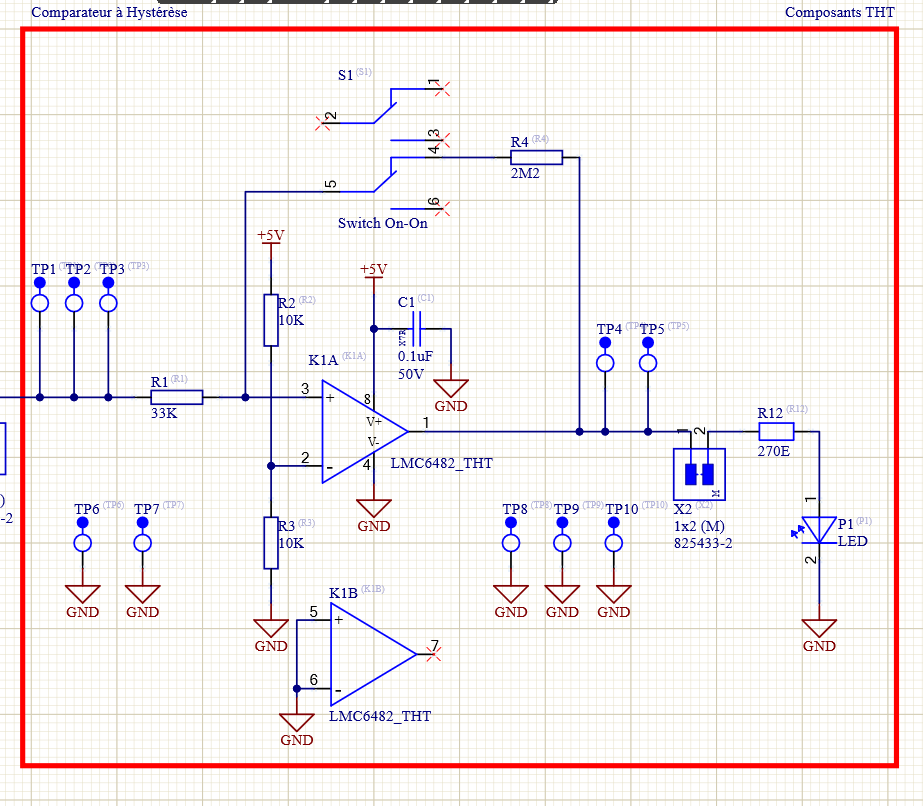
[picture p45: figure]

## 6.3 Liste des délivrables

pcb | Schématique (.pdf)
| Fichier : | projectname-pcb-schema-vx.x.x.pdf | annexé
| Répertoire : | .\projectname\pcb\pdf\
pcb | Plan d’implantation (.pdf)
| Fichier : | projectname-pcb-implantation-bot-vx.x.x.pdf | annexé
| Fichier : | projectname-pcb-implantation-top-vx.x.x.pdf | annexé
| Répertoire : | .\projectname\pcb\pdf\
pcb | Gerber (.zip)
| Fichier : | projectname-pcb-gerber-vx.x.x.zip
| Répertoire : | .\projectname\pcb\
fwr | Firmware (.hex)
| Fichier :
| Répertoire :
swr | Software (.exe)
| Fichier :
| Répertoire :
mec | Plan mécanique (.pdf)
| Fichier :
| Répertoire :
rpt | Liste de matériel (.pdf)
| Fichier : | projectname-pcb-bom-vx.x.x.pdf | annexé
| Répertoire : | .\projectname\pcb\bom\

## 6.4 Amélioration possible

Ajour d’une source lumineuse sur le capteur de référence pour imiter un « soleil » et sur le capteur de mesure pour avoir des capteurs qui ne sont pas perturbé par l’extérieur (nuages, éclairage…). Ajout d’une LED lampadaire pour avoir une application plus réaliste et sympa a utilisé.

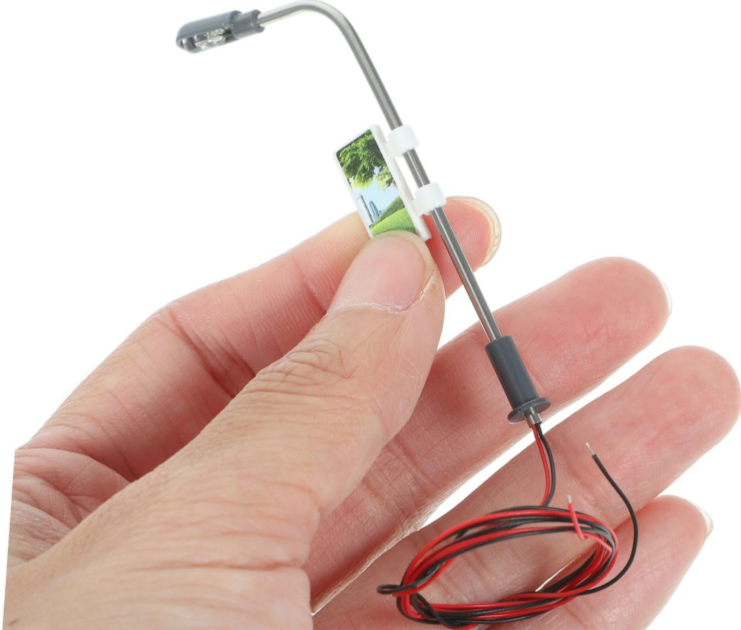
[picture p46: figure]

Ajout d’un petit rail avec un cache coulissant sur le capteur de mesure pour pouvoir plus facilement et plus précisément cacher la lumière et ainsi avoir des valeurs de mesures plus précises.

## 6.5 Conclusion et avis personnel

### 6.5.1 Signatures

Lieu: | EMF, 1705 Fribourg, Switzerland | _________________________
Date: | | myname myfirstname

### 6.5.2 Sources

- https://www.fr.ch/emf

### 6.5.3 Version de ce document

version | date | qui | modification
V1.0.0 | 20210510 | gauchl | Première version

### 6.5.4 Annexes

projectname-rpt-development.docx 4 / 8

EMF: Projet Electronicien CFC Carte Electronique Didactique PittetL02
