PittetL02/tpi_carte_electronique_didactique_pittetl02/rpt/Presentation/carte_electronique_didactique_PittetL02-rpt-presentation.pptx

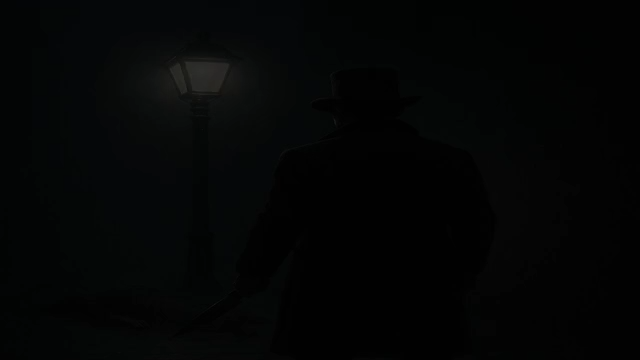
[picture p47: figure]

Notes: Alertes Infos!
Des nouveautés concernant l’affaire Jack The Reaper.
Il aurait été aperçu dans les rues de Londres juste après avoir commis son 5ème meurtre.
Cependant, l’éclairage publique était défaillant en scintillant fortement ce qui a permis au meurtrier de s’enfuir.
Comment un éclairage public peut fonctionner de cette sorte. Comment améliorer ceux-ci pour que sérénité et confiance règne dans les rues le soir et la nuit?
Nous allons voir tout ceci avec une proposition de M.Pittet expert en électronique.

## Carte Electronique didactique pour Module E213

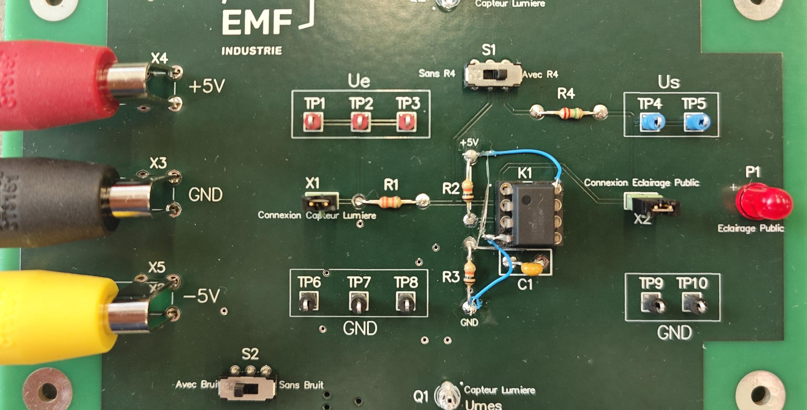
[picture p48: figure]
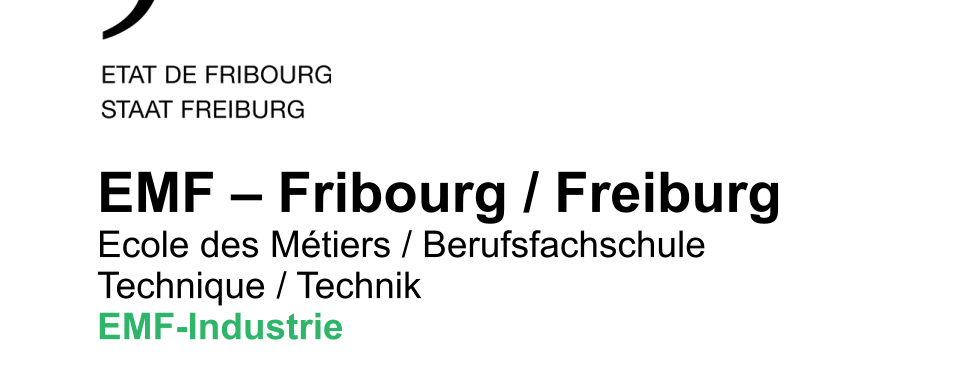
[picture p49: figure]

- EMF / Ecole des Métiers / Berufsfachschule – Fribourg Pittet Loïc Candidat Electrocicien CFC TPI 2024 / 2025

## Déroulement de cette présentation

1. Objectif du projet?
2. Plannification
3. Décision prise lors de ce projet.
4. Réalisation
  1. Schématique
  2. PCB
  3. Firmware
5. Contrôle
6. Evaluation

## 1. Information: Objectifs du projet

Réalisation d’une carte électronique didactique.
Intégrer un capteur analogique.
Simuler un concept de la vie de tous les jours.
Générer du bruit manuellement.

## 1. Information: Tâches à réaliser

Concevoir un conditionneur.
Réaliser du bruit via un uC.
Conception d’une schématique.
Conception d’un PCB.

## 2. Plannification

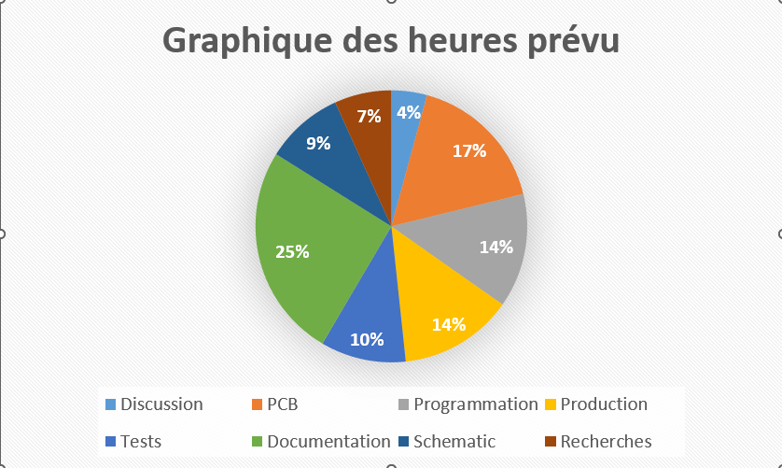
[picture p50: figure]
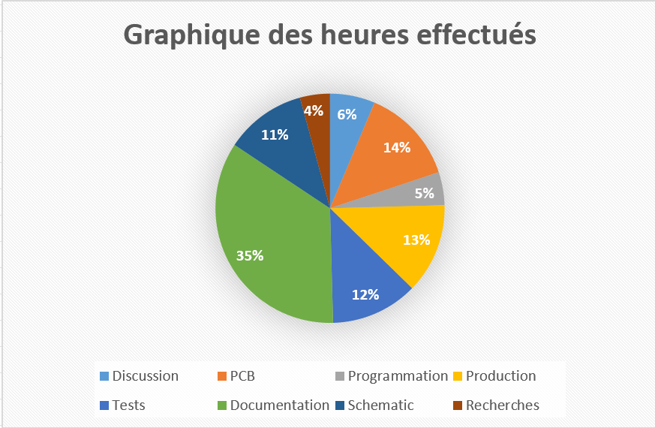
[picture p51: figure]

## 3. Décision: les plus importantes

Changer de capteur de lumière
Méthode pour la génération du bruit
Ajout d’un deuxième capteur.
Inverser la soustraction entre les capteurs

Notes: Capteur lumière : LDRs trop polluant avec du Cadmium.
Bruit : LSFR (Bruit numérique par pseudo-aléatoire) / PWM

## 4. Réalisation: Schéma bloc

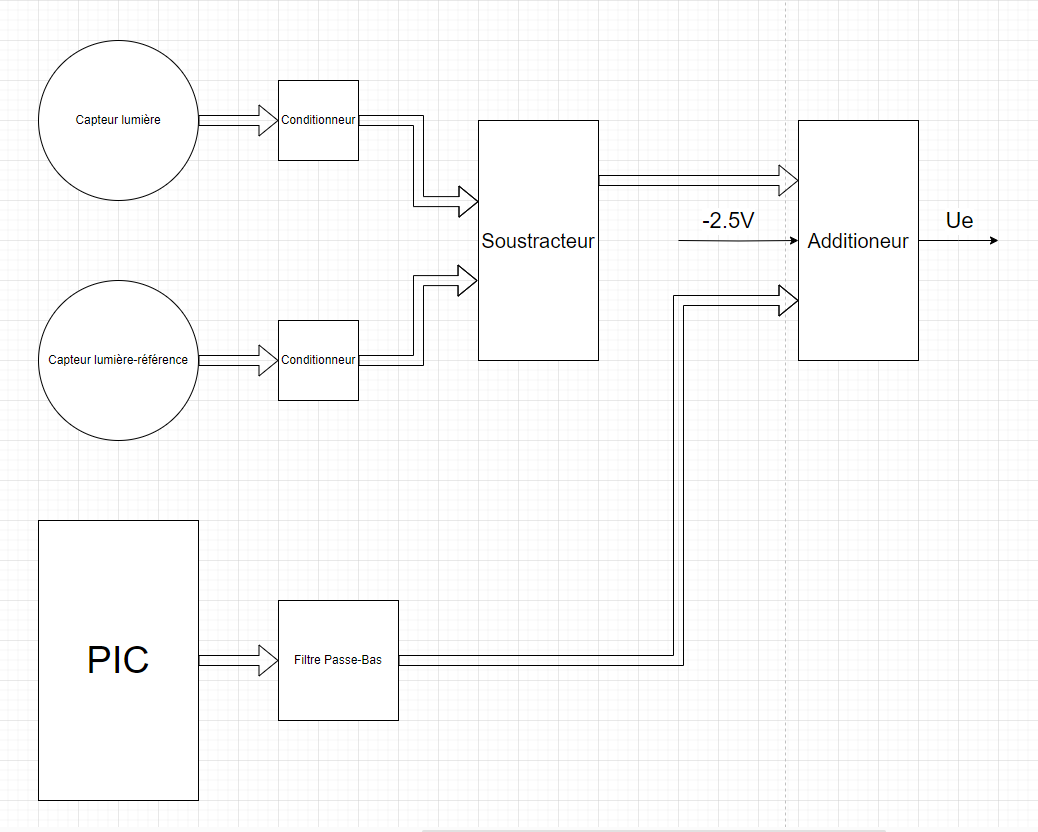
[picture p52: figure]

## 4.1 Réalisation: Schématique Globale

## 4.1.1 Réalisation: Schématique Soustracteur


## 4.1 Réalisation: Schématique Globale

## 4.1.2 Réalisation: Schématique Additionneur

Gv=(−R6)/(R7)=(−10kΩ)/(22kΩ)=−0.4545−5V⋅Gv=−5V⋅(−0.4545)=2.2727V

## 4.1 Réalisation: Schématique Globale

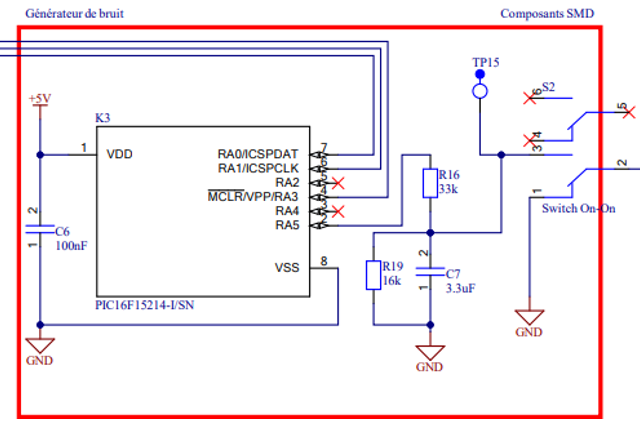
[picture p53: figure]

## 4.1.3 Réalisation: Schématique Générateur de Bruit


## 4.1 Réalisation: Schématique Globale

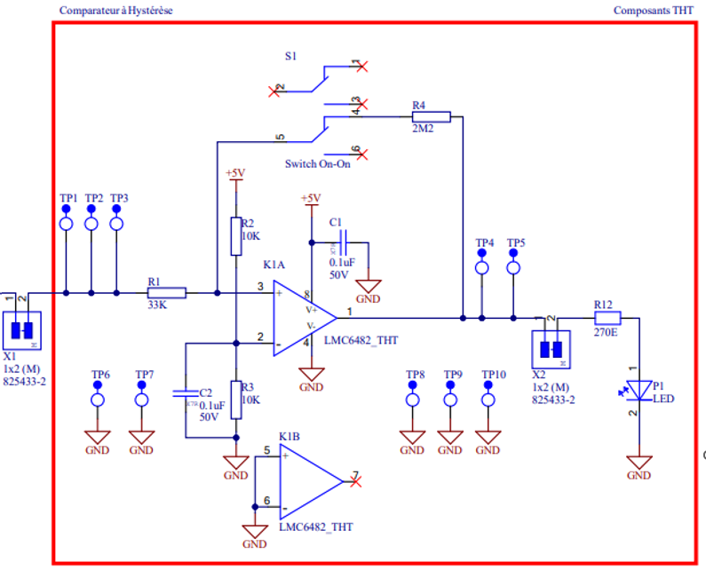
[picture p54: figure]

## 4.1.4 Réalisation: Schématique Comparateur Hystérèse

## 4.2.1 Réalisation: PCB Routage

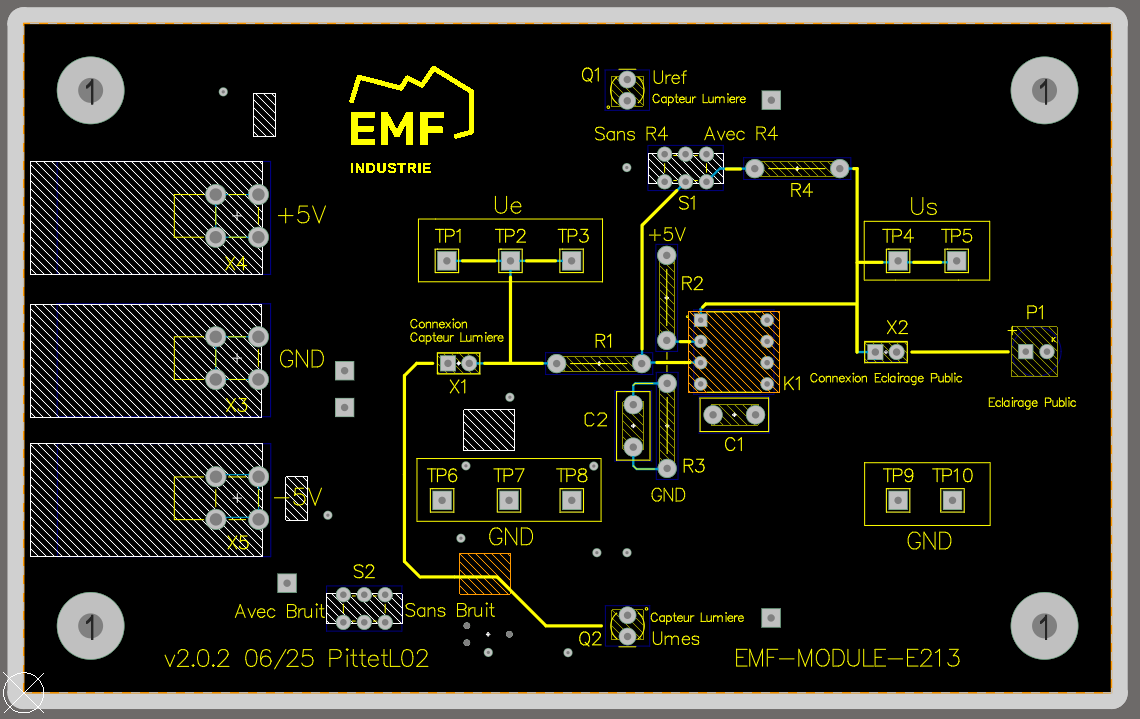
[picture p55: figure]
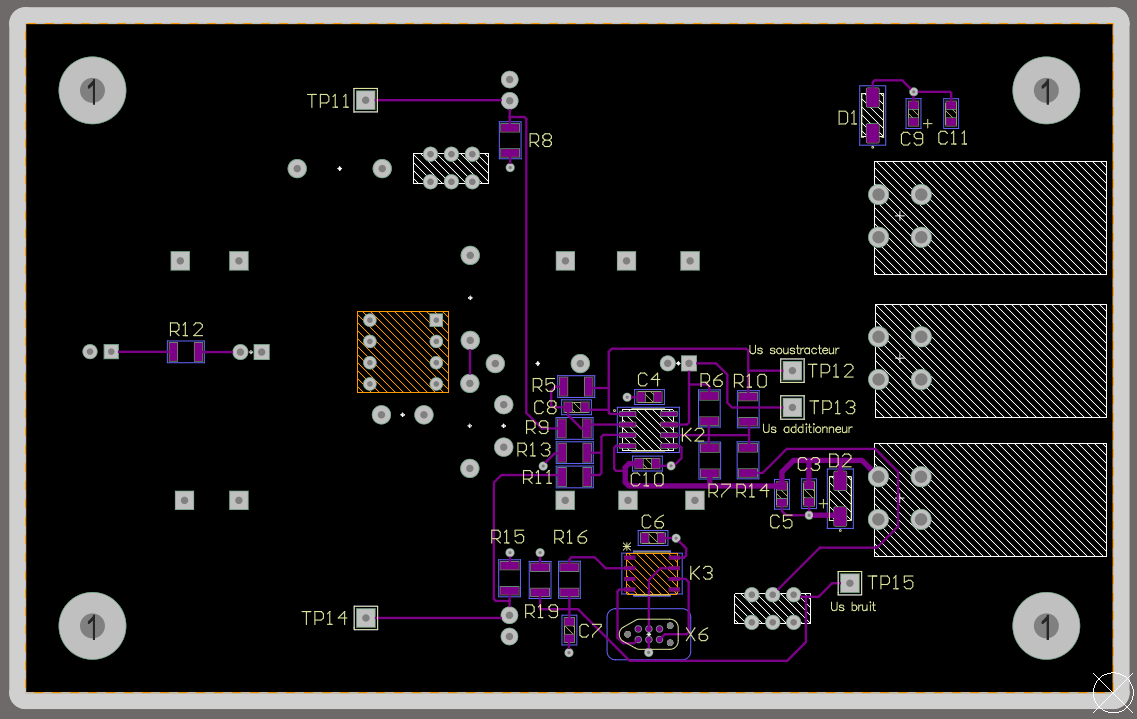
[picture p56: figure]
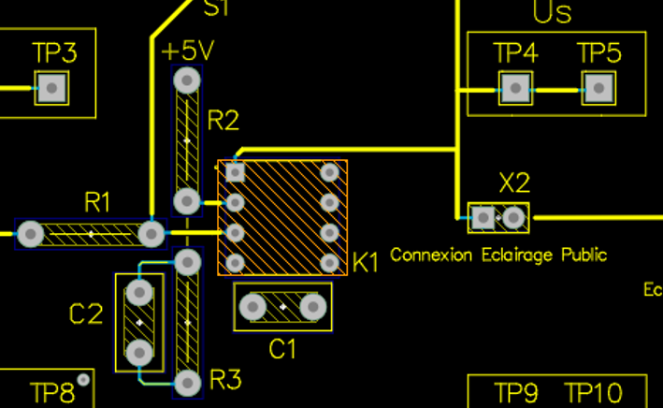
[picture p57: figure]
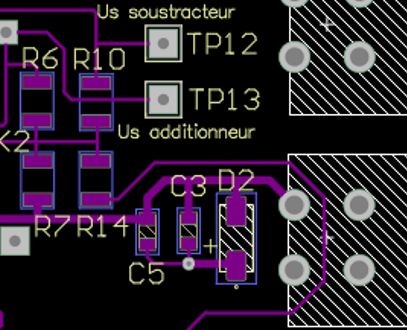
[picture p58: figure]

## 4.2.1 Réalisation: Règles Routage

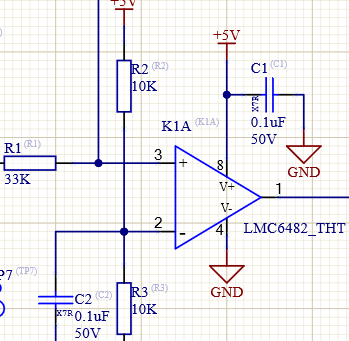
[picture p59: figure]

## 4.2.1 Réalisation: PCB Routage

## 4.2.1 Réalisation: PCB Routage

## 4.2.2 Réalisation: PCB 3D

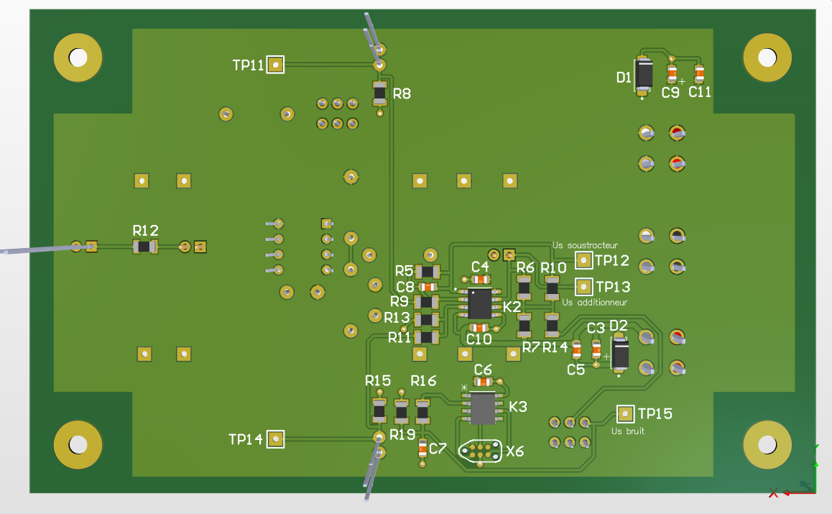
[picture p60: figure]
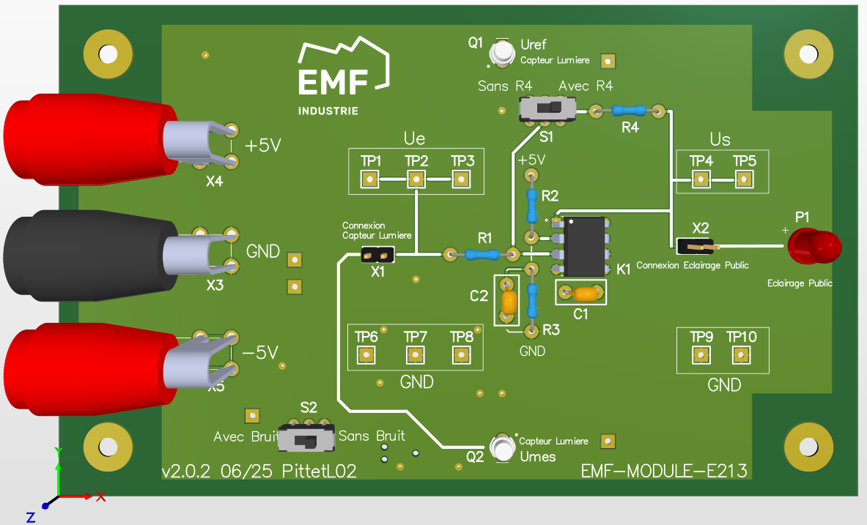
[picture p61: figure]

## 4.3 Réalisation: Firmware, Stuctogramme

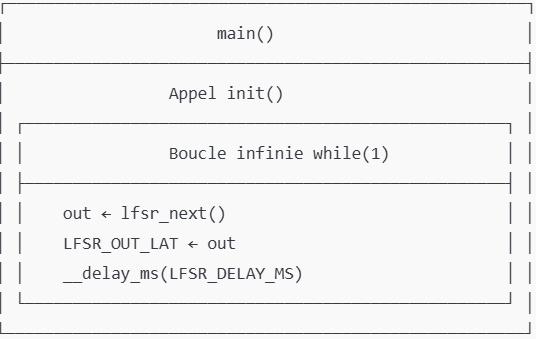
[picture p62: figure]
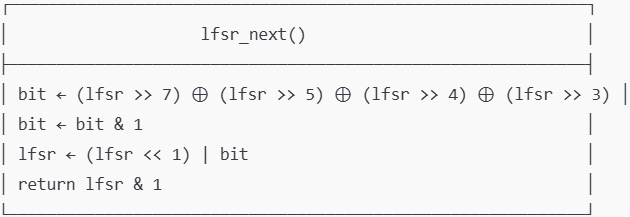
[picture p63: figure]

## 4.3 Réalisation: Firmware, Résultat

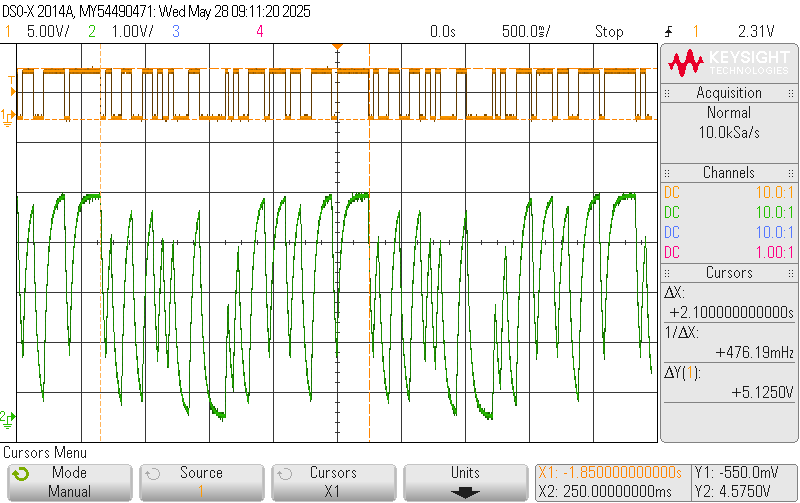
[picture p64: figure]

## 5. Contrôle Mise en service

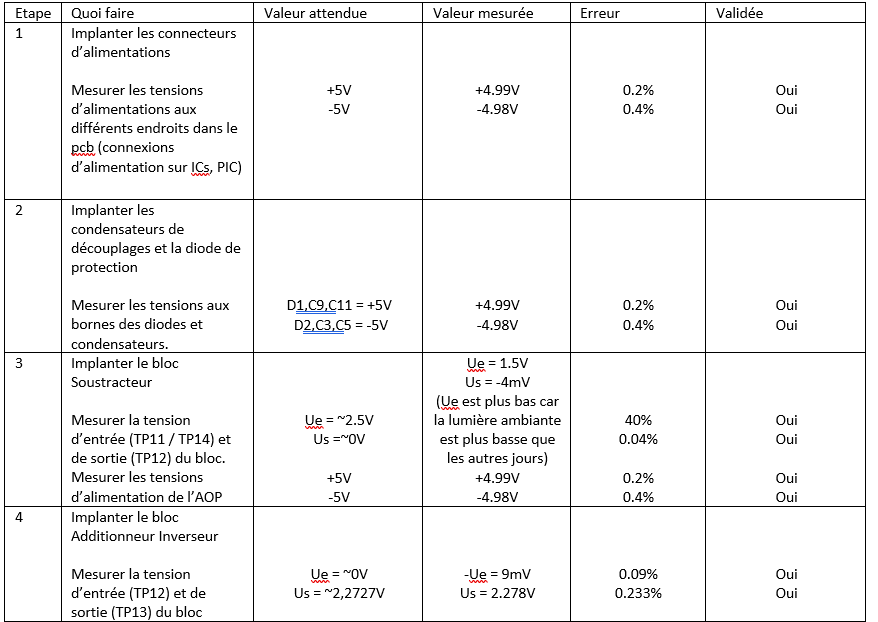
[picture p65: figure]
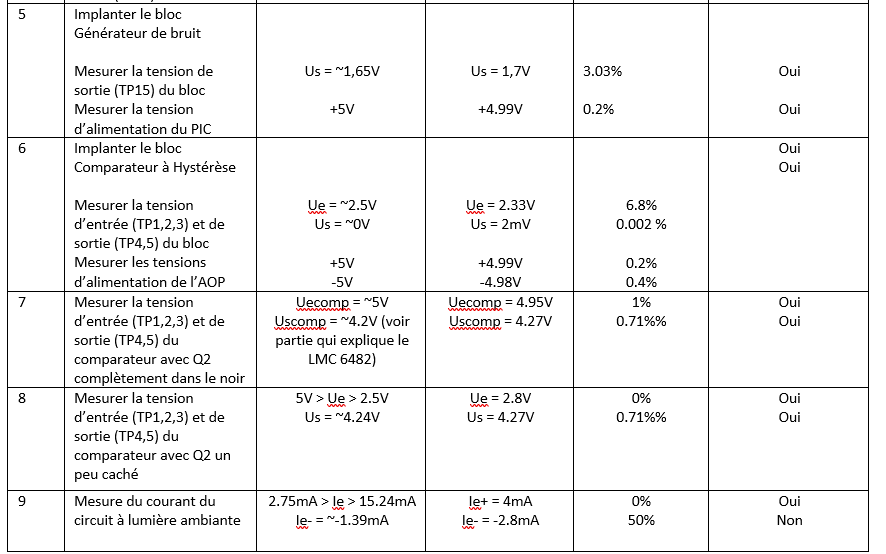
[picture p66: figure]

## 6. Evaluation: Modifications

  - Inverser K1 en entier
  - Inverser condensateur C3
  - Ajout de test points
  - Ajout de deux condensateurs pour lissage du signal
  - Changement empreinte Phototransistor
  - Ajout de SilkScreen sur les pistes TOP

## 6. Evaluation: Modifications

## 6. Evaluation: Modifications

  - Inverser K1 en entier
  - Inverser condensateur C3
  - Ajout de test points
  - Ajout de deux condensateurs pour lissage du signal
  - Changement empreinte Phototransistor
  - Ajout de SilkScreen sur les pistes TOP

## 6. Evaluation: Modifications

## 6. Evaluation: Modifications

  - Inverser K1 en entier
  - Inverser condensateur C3
  - Ajout de test points
  - Ajout de deux condensateurs pour lissage du signal
  - Changement empreinte Phototransistor
  - Ajout de SilkScreen sur les pistes TOP

## 6. Evaluation: Modifications

## 6. Evaluation: Modifications

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

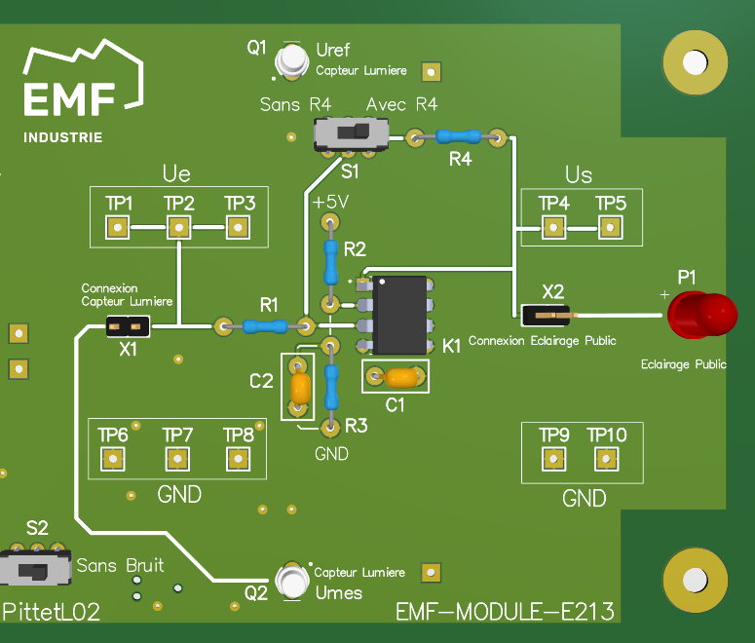
[picture p67: figure]

## 6. Evaluation: Modifications

## 6. Evaluation: Amélioration

- Changer les Jumpers X1 et X2 par des switchs
- Ajout d’un rail pour cacher les capteurs
- Ajout d’une LED lampadaire
- Ajout gaine thermo sur capteurs

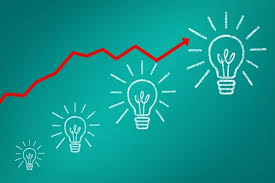
[picture p68: figure]

## 6. Evaluation: Avis personnel

- Les +
- Les -

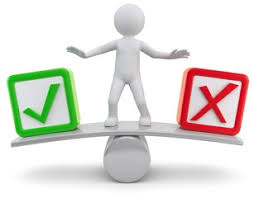
[picture p69: figure]

EMF / NOM Prénom / Data <-- à modifier partout avec Insertion -> En-tête/Pied -> Pied de page

## Slide 35

Merci pour votre écoute
Avez-vous des questions … ?

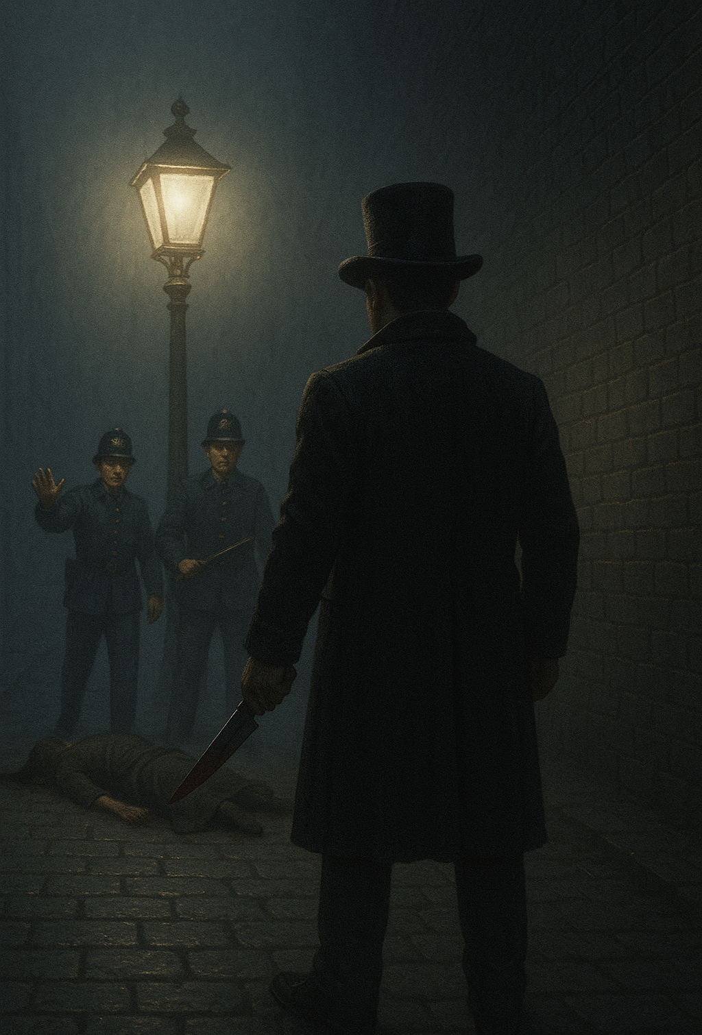
[picture p70: figure]

Notes: Alertes Info!
Des nouveautés concernant l’affaire Jack The Reaper!
Il aurait été interpellé hier dans la nuit aux alentours de 2h du matin.
En effet, la police a pu débarquer à temps pour éviter un nouveau meurtre. Cependant la victime est fortement blessé mais est vivante.
Les policiers ont remarqué une luminosité étonnamment bonne.
Nous remercions donc M.Pittet expert en électronique d’avoir pu résoudre de problème d’éclairage publique.
La sérénité et la confiance reviendra dans les rues de Londres ces prochaines semaines.
