PittetL02/tpi_carte_electronique_didactique_pittetl02/Module E213/Hystérèse - Préambule.pdf

Module E213 | Applications pratiques | Générateur tri/rect

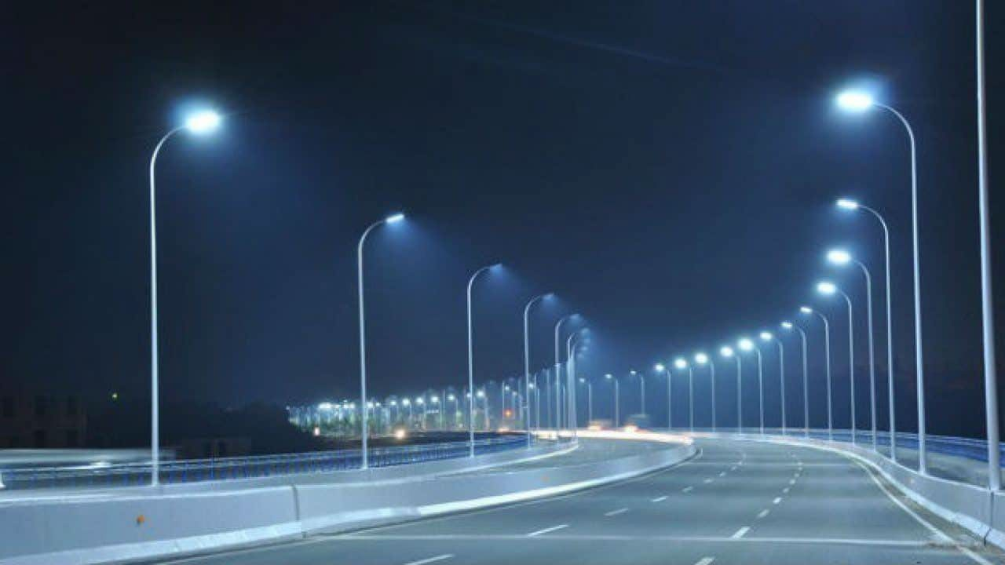
[picture p119: figure]
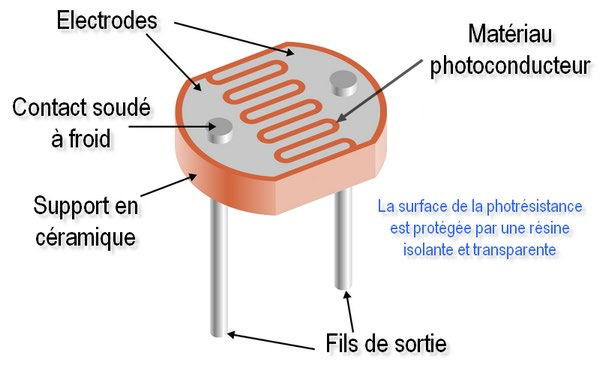
[picture p120: figure]
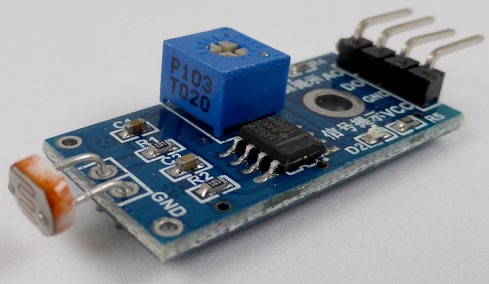
[picture p121: figure]

Hystérèse - Préambule.docx | Page: 1/2

## Comparateurs : applications pratiques

Application pratique hyst1
Explication du contexte

L’éclairage public doit
s’allumer lorsque la lumière naturelle baisse en soirée et doit s’éteindre lorsque le jour se lève.

On utilise un capteur de lumière pour enclencher et déclencher l’éclairage, c’est une LDR (Light Dependent Resistor) dont la résistance varie avec l’intensité lumineuse :

Cette LDR est couplée à un conditionneur de signal (module électronique) pour sortir une valeur sous
la forme d’une tension :

Le module ainsi formé fournit une tension de sortie Us inversement proportionnelle à la lumière incidente :
- Lorsqu’il fait nuit, Us est grande (~5V)
- Lorsqu’il fait jour, Us est faible (~0V)
- Lorsque la luminosité est moyenne,
Us est moyenne (~2.5V)

Us [V]

Intensité
lumineuse [cd]

5

0

2.5

nuit | jour

Module E213 | Applications pratiques | Générateur tri/rect
Hystérèse - Préambule.docx | Page: 2/2

La tension de sortie de ce module est appliquée aux bornes A et B d’entrée du Circuit 1 (décrit plus loin) :

LDR | Conditionneur

Module

Circuit 1 Etage de
puissance

Eclairage
public

Long câble

Malheureusement à l’EMF nous n’avons pas ce module à LDR. Pour faire les mesures demandées, vous devrez imiter ce module avec un générateur, 2 résistances fixes et un potentiomètre (voir plus loin).
La LED D1 symbolise l’éclairage public dans les mesures suivantes :

Simulation de
la tension
donnée par le
module

Circuit 1

Simulation de
l’éclairage
public avec
une LED

Le module est installé dans un endroit dégagé à l’extérieur d’un bâtiment (p. ex. sur le toit) alors que le Circuit 1 est dans un boîtier de commande à l’intérieur du bâtiment. La sortie du module est reliée à l’entrée du Circuit 1 par un long câble qui peut capter des perturbations électromagnétiques (= parasites, bruit électronique1).

1 Le bruit électronique est un signal aléatoire indésirable qui se superpose au signal utile, rendant plus difficile la distinction de ce dernier.
