PittetL02/tpi_carte_electronique_didactique_pittetl02/Module E213/Hystérèse_s.pdf

Module E213 | Applications pratiques | Générateur tri/rect

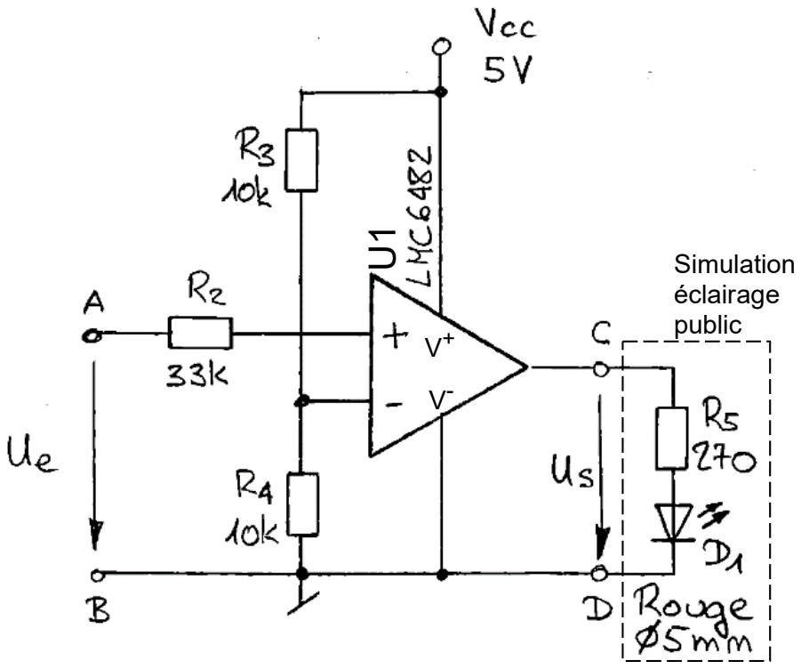
[picture p122: figure]
Simulation éclairage public

Hystérèse_s.docx | Page: 1/5

## Comparateurs : applications pratiques

Application pratique hyst1
Sur la base de réflexions et de calculs théoriques, répondez aux questions suivantes concernant le schéma ci-contre :

Quel est le nom du circuit réalisé autour de U1 ?
Comparateur simple non-inverseur

Schéma du Circuit 1 :

Quelle condition la tension Ue doit-elle remplir afin que la LED D1 soit allumée ?
D1 est allumée si Us = Us Haut ⇒ si U+ > U- ⇒ si Ue > 2.5V

Quelle condition la tension Ue doit-elle remplir afin que la LED D1 soit éteinte ?
D1 est éteinte si Us = Us Bas ⇒ si U+ < U- ⇒ si Ue < 2.5V

Dessinez la caractéristique de transfert théorique Us = f(Ue) :

Résumez le comportement théorique de la LED D1 en fonction de la tension d’entrée Ue :

D1 est éteinte lorsque Ue < 2.5V et allumée lorsque Ue > 2.5V U¹

4.7

Us [V]

Ushaut = V+-Udrop+ = Vcc-Udrop+ Usbas = V-+Udrop- = 0V+Udrop-
Selon datasheet p. 3
(VO Output Swing) :
Ushaut = 4.7VTyp
Usbas = 0.3VTyp

0

0.3 | Ue [V] 0 | 2.5 | 5

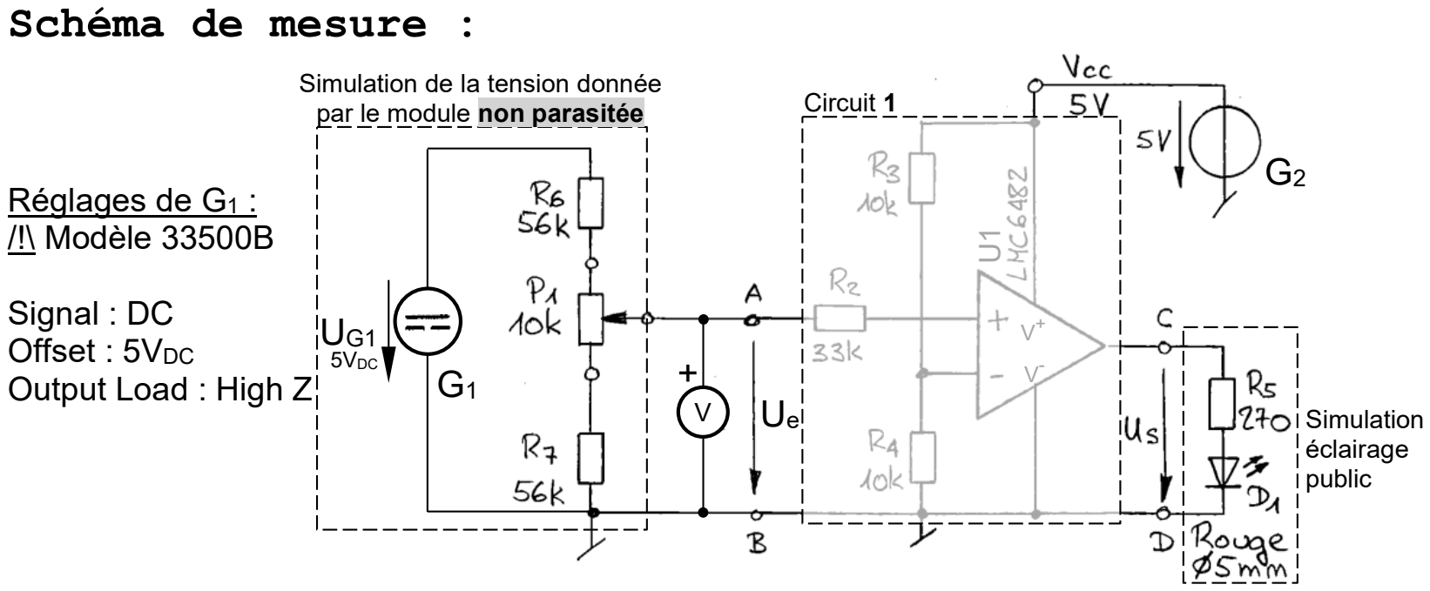
[picture p123: figure]
Schéma de mesure :; Circuit 1; Réglages de G1 : /!\ Modèle 33500B; Signal : DC Offset : 5VDC Output Load : High Z; Simulation de la tension donnée par le module non parasitée; 5VDC; Simulation éclairage public

Le générateur de fonctions G1 réglé comme ceci est équivalent à une source de tension DC.
A l’aide du potentiomètre P1, on peut faire varier la tension DC d’entrée UeDC entre 2 limites DC. On peut ainsi simuler le signal donné par le module du capteur lorsque la lumière naturelle varie. Calculez les valeurs théoriques minimale et maximale de UeDC que P1 permet de simuler :
Lorsque le curseur de P1 est tout en bas :
Ω = | = | ⋅ | = | ⋅ | = + | + | Ω+ | Ω+ | Ω ⁷
7
e min | R | G1
6 | 1 | 7
R | 56k
U | U | U | 5V | 2.3V
R P R | 56k | 10k | 56k

Lorsque le curseur de P1 est tout en haut :

( | ) +
+ | Ω+ | Ω = | = | ⋅ | = | ⋅ | = 1 | 7 | + | + | Ω+ | Ω+ | Ω
| | | | | | | | | 1 | 7
e max | PR | G1
6 | 1 | 7
P R | 10k | 56k
U | U | U | 5V | 2.7V
R P R | 56k | 10k | 56k
Sur la base du schéma précédent, réalisez ce montage sur plaque d’expérimentation.
Faites varier P1 et observez le comportement réel de la LED D1. Indiquez ci-dessous vos observations :
Lorsque Ue < 2.5V, la LED est éteinte,
lorsque Ue > 2.5V, la LED est allumée.

La LED D1 se comporte-t-elle réellement comme prévu théoriquement à la page 1 ?
Oui

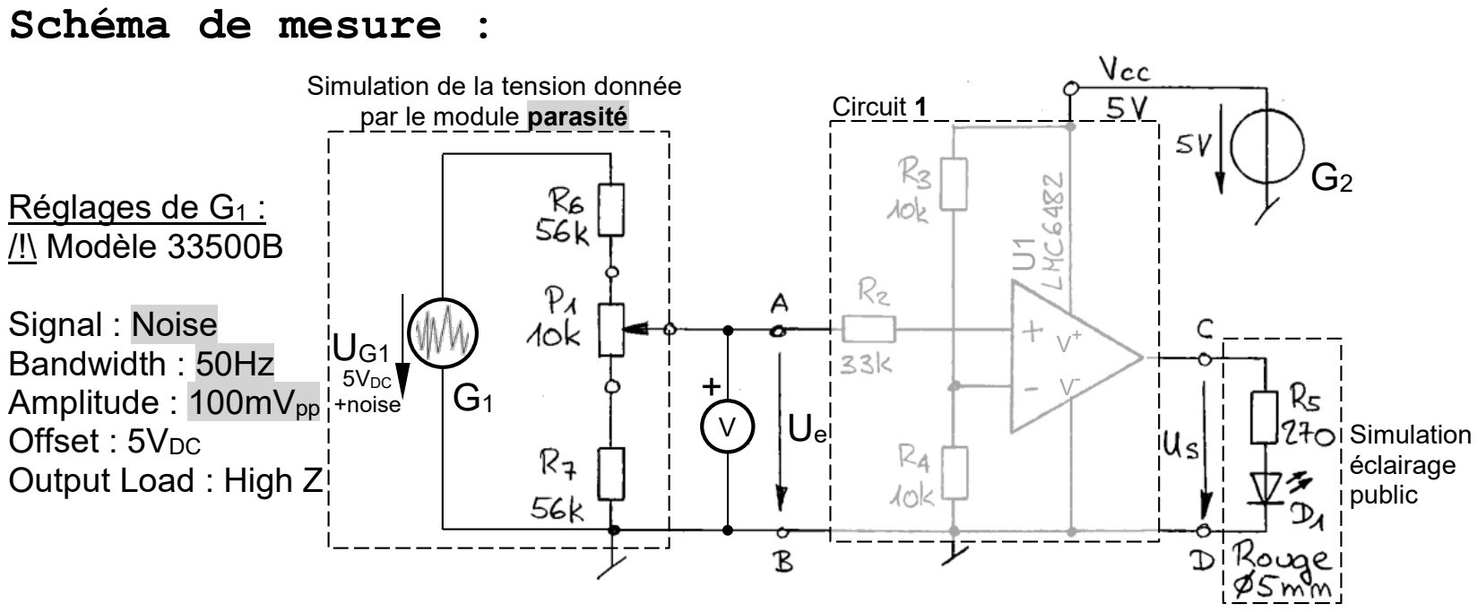
[picture p124: figure]
Schéma de mesure :; Circuit 1; Réglages de G1 : /!\ Modèle 33500B; Signal : Noise Bandwidth : 50Hz Amplitude : 100mVpp Offset : 5VDC Output Load : High Z; Simulation de la tension donnée par le module parasité; 5VDC +noise; Simulation éclairage public

Modifiez les réglages du générateur de fonctions G1 comme indiqué ci-dessus. Maintenant le générateur est équivalent à une source de tension DC sur laquelle on a ajouté du bruit. G1 et P1 simulent alors le signal donné par le module soumis à des parasites.
Faites varier P1 et observez le comportement réel de la LED D1. Indiquez ci-dessous vos observations :
Lorsque Ue est très proche de 2.5VDC, la LED n’est pas pleinement allumée ni éteinte, mais elle clignote. La sortie n’est donc stable ni à l’état haut, ni à l’état bas.
La transition entre le niveau haut et bas n’est pas franche.

La LED D1 se comporte-t-elle réellement comme prévu théoriquement à la page 1 ?
Non, il devrait y avoir une transition nette de la sortie lorsque la tension d'entrée passe le seuil.

A votre avis, d’où provient ce comportement ?
Du bruit sur la tension Ue qui fait osciller la sortie.

La LED D1 symbolise l’éclairage public. Voyez-vous un problème de fonctionnement avec ce Circuit 1 ?
Oui, lorsque lumière du jour commencera à baisser et atteindra le seuil auquel l’éclairage public devrait s’allumer, au lieu de s’allumer et de rester allumé, il va clignoter (s’allumer puis s’éteindre et se rallumer juste après) durant plusieurs minutes, jusqu’à ce qu’il fasse suffisamment nuit pour qu’il reste allumé.

Ajoutez au Circuit 1 la résistance R1 comme ci-contre :

Schéma du Circuit 2 :

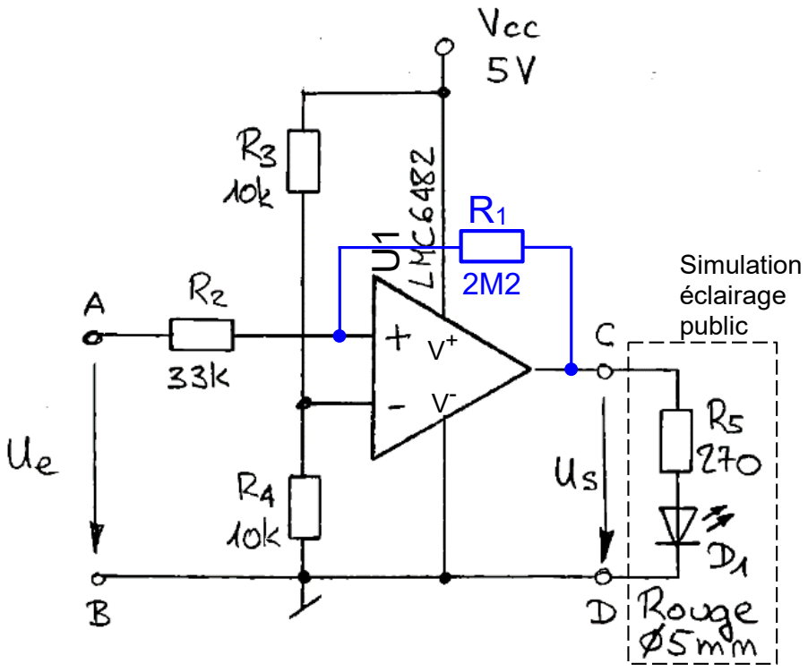
[picture p125: figure]
Simulation éclairage public

Faites varier P1 et observez le comportement réel de la LED D1. Indiquez ci-dessous vos observations :
La transition entre les états est cette fois-ci très nette, mais le niveau pour passer de l’état bas à l’état haut n’est pas le même que celui pour passer de l’état haut à l’état bas.

Que provoque la résistance R1 ?
De l’hystérèse.

On désire mesurer la caractéristique de transfert Us = f(Ue) du Circuit 1 puis du Circuit 2 pour toute la plage de la tension d’entrée. On pourrait relever point par point une succession de mesures statiques1 en faisant varier manuellement Ue avec une alimentation de laboratoire et en mesurant Us avec un voltmètre, mais on peut aussi plus élégamment visualiser la caractéristique de transfert sur l’écran de l’oscilloscope en mode XY en mesure quasi-statique1. Cette mesure, de prime abord anodine, est cependant assez délicate et demande des réglages particuliers :
Il faut faire varier automatiquement Ue entre 0V et 5V. Mais :
- Si Ue varie trop lentement, la trace ne sera pas visible sur l’oscillo, on ne verra qu’un point qui se déplace lentement.
- Si Ue varie trop rapidement, la vitesse de réaction limitée de l’AOP faussera la mesure (visible déjà à 400Hz, essayez !).
- Un bon compromis est de choisir la fréquence du signal à 25Hz. Complétez ci-dessous le schéma de mesure nécessaire et donnez le réglage de tous les appareils :

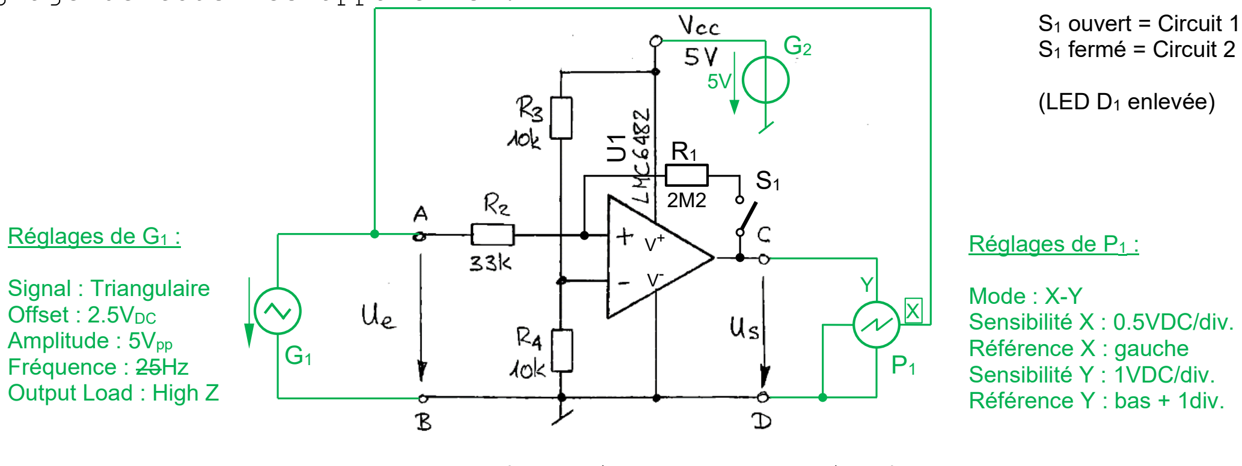
[picture p126: figure]
Réglages de P1 :; Mode : X-Y Sensibilité X : 0.5VDC/div. Référence X : gauche Sensibilité Y : 1VDC/div. Référence Y : bas + 1div.; Réglages de G1 :; Signal : Triangulaire Offset : 2.5VDC Amplitude : 5Vpp Fréquence : 25Hz Output Load : High Z; S1 ouvert = Circuit 1 S1 fermé = Circuit 2; (LED D1 enlevée)

Pour effectuer une bonne copie d’écran (c’est-à-dire une « photo instantanée » de l’écran), il faut que la trace « laisse une traînée » sur l’écran, il faut augmenter la persistance d’affichage :
Bouton Display > Menu Persistence > choisir Variable persistence ;
Menu Time > choisir 100ms.
Imprimez une copie d’écran de votre oscilloscope, mettez en évidence les valeurs particulières sur la copie d’écran imprimée, puis appelez, pour chaque mesure, le formateur afin qu’il puisse comparer l’affichage sur votre oscilloscope et votre impression sur papier. Avec une échelle horizontale de 500mV/div, le phénomène à visualiser sur le Circuit 2 est de même ordre de grandeur que l’épaisseur de la trace, il n'est donc pas visible. Zoomez horizontalement à 50mV/div pour le voir. (Prenez une copie d'écran avec chaque échelle.)
Si vous deviez tout de même mesurer la caractéristique de transfert d’un comparateur à hystérèse manuellement point par point (mesure statique1), à quoi devriez-vous faire attention ?
Il faut mesurer des points avec Ue croissant de 0V à 5V et aussi mesurer des points avec Ue décroissant de 5V à 0V pour visualiser l’hystérésis !
1 Voir extrait du glossaire d'électronique (p. 57, 28 et 45)
