PittetL02/tpi_carte_electronique_didactique_pittetl02/fwr/readme.md

# Dossier "fwr"

 Contient toutes les informations nécessaires au développement du firmware du système à micro.
 Ce dossier est spécialement conçu pour contenir un projet MPLABX.
