PittetL02/tpi_carte_electronique_didactique_pittetl02/sim/readme.md

# Dossier "sim"

 Contient toutes les informations à de la simulation ou émulation du système à micro.
