PittetL02/tpi_carte_electronique_didactique_pittetl02/rpt/draw/readme.md

# Dossier "draw"

 Contient les dessins réalisés pour le projet.
 Note: Un fichier projectname-rpt-draw.drawio peut contenir tous les dessins vectoriels.
