PittetL02/tpi_carte_electronique_didactique_pittetl02/rpt/photo/readme.md

# Dossier "photo"

 Contient les fichiers de photos en .jpg, .png ou autres format.
 Ces photos ou images, peuvent être modifié avec Gimp.
