PittetL02/tpi_carte_electronique_didactique_pittetl02/rpt/video/readme.md

# Dossier "video"

 Contient les fichiers de video en .vid, .mp3 ou autres format.
