PittetL02/tpi_carte_electronique_didactique_pittetl02/rpt/photo/Oscilloscope/Signal_Entré/Signal_DC/Signal_DC_Avec_Bruit.png

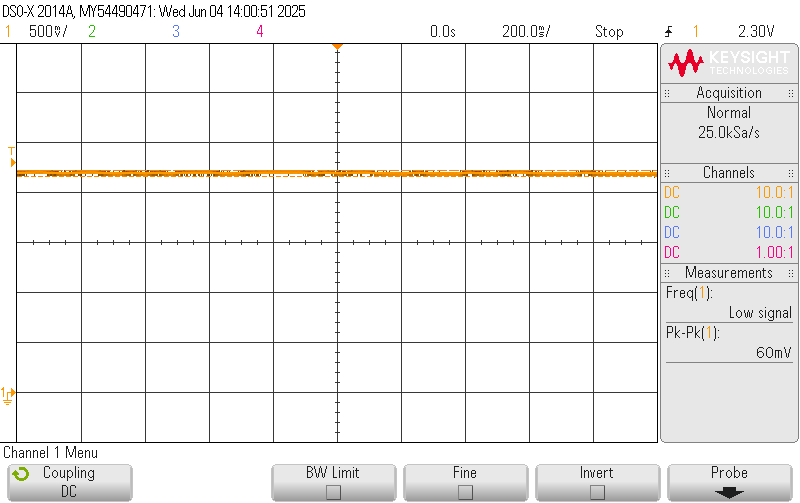
rpt/photo/Oscilloscope/Signal_Entré/Signal_DC/Signal_DC_Avec_Bruit.png
