PittetL02/tpi_carte_electronique_didactique_pittetl02/pcb/bom/readme.md

# Dossier "bom"

 Contient le dernier fichier 'bill-of-material' généré.
