PittetL02/tpi_carte_electronique_didactique_pittetl02/rpt/order/readme.md

# Dossier "order"

 Contient les commandes de matériel pour le projet, y compris la commandes des PCB.
