PittetL02/tpi_carte_electronique_didactique_pittetl02/pcb/bom/V3.0.1/carte_electronique_didactique_PittetL02_Project.xlsx

Sheet: Sheet1
 | EMF 3.0.1 |  |  | Ecole des Métiers de Fribourg | Désignation: |  | TPI_PittetL02
 | Révision |  | Date | PROTOTYPE
 | 3.0.1 | PittetL02 | 23/05/25
 | EMF 3.0.1
Item | Quantity | Name |  | Description | Designator | Fabricant | N° Frabricant | Distributeur | N° Commande | Prix unité | Sous total
1 | 1 | Connecteur Banane GND |  |  | X3 | Cal Test Electronics | CT3151-0 | DigiKey | BKCT3151-0-ND | 2.07 | 2.07
2 | 1 | Connecteur Banane VCC |  |  | X4 | Cal Test Electronics | CT3151-2 | DigiKey | BKCT3151-2-ND | 2.07 | 2.07
3 | 1 | Connecteur Banane VDD |  |  | X5 | Cal Test Electronics | CT3151-4 | DigiKey | BKCT3151-4-ND | 2.07 | 2.07
4 | 1 | LED |  |  | P1 | Kingbright | WP7113ID | DigiKey | 754-1264-ND | 0.16 | 0.16
5 | 1 | LMC6482_SMD |  |  | K2 | Texas Instruments | LMC6482AIMX/NOPB | DigiKey | LMC6482AIMX/NOPBCT-ND | 1.43 | 1.43
6 | 1 | LMC6482_THT |  |  | K1 | Texas Instruments | LMC6482IN/NOPB | DigiKey | LMC6482IN/NOPB-ND | 3.70 | 3.70
7 | 1 | PIC16F15214-I/SN |  |  | K3 | MICROCHIP | PIC16F15214-I/SN | DigiKey | 150-PIC16F15214-I/SN-ND | 0.45 | 0.45
8 | 4 | trou |  |  | TR1, TR2, TR3, TR4 |  |  |  |  |  | 0.00
9 | 1 | 3.3uF |  | 805 | C7 | KEMET | C0805C335K4PACTU | DigiKey | 399-C0805C335K4PACTUCT-ND | 0.42 | 0.42
10 | 2 | 10uF |  | 805 | C3, C9 | KYOCERA AVX | TPSP106M010R2000 | DigiKey | 478-9264-1-ND | 0.46 | 0.92
11 | 5 | 100nF |  | 805 | C4, C5, C6, C10, C11 | Samsung Electro-Mechanics | CL21B104KBCNNNC | DigiKey | 1276-1003-1-ND | 6.00 | 30.00
12 | 1 | 470nF |  | 805 | C8 | KEMET | C0805C474K3REC7210 | DigiKey | 399-C0805C474K3REC7210CT-ND | 0.21 | 0.21
13 | 2 | 0.1uF |  | C CER X7R 0,1uF/50V 20% DEC (E=5) | C1, C2 | KEMET | C320C104K5R5TA | DigiKey | 399-4264-ND | 0.18 | 0.36
14 | 1 | 1x6 |  | Conn. avec plage pour contact à ressort TAG-Connect TC2030-IDC-NL | X6 | Tag-Connect LLC | TC2030-IDC | DigiKey | TC2030-IDC-ND | 43.71 | 43.71
15 | 2 | SMAZ5V6-13-F |  | Diode zener | D1, D2 | Diodes Incorporated | SMAZ5V6-13-F | DigiKey | SMAZ5V6-FDICT-ND | 0.24 | 0.48
16 | 2 | SFH-3310_EN |  | Photo-transistor | Q1, Q2 | AMS OSRAM GROUP | SFH 3310 | DigiKey | 475-SFH3310-ND | 0.86 | 1.72
17 | 2 | TP bleu |  | Point de test CI isolé bleu | TP4, TP5 | Keystone Electronics | 5117 | DigiKey | 36-5117-ND | 0.39 | 0.78
18 | 5 | TP noir |  | Point de test CI isolé noir | TP6, TP7, TP8, TP9, TP10 | Keystone Electronics | 5001 | DigiKey | 36-5001-ND | 0.39 | 1.95
19 | 8 | TP rouge |  | Point de test CI isolé rouge | TP1, TP2, TP3, TP11, TP12, TP13, TP14, TP15 | Keystone Electronics | 5000 | DigiKey | 36-5000-ND | 0.39 | 3.12
20 | 1 | 2M2 |  | R METAL 2M2 1% 1/2W | R4 | Stackpole Electronics Inc | CFM14JT2M20 | DigiKey | S2.2MQCT-ND | 0.08 | 0.08
21 | 2 | 10K |  | R METAL 10K 1% 1/2W | R2, R3 | Stackpole Electronics Inc | CFM14JT10K0 | DigiKey | S10KQCT-ND | 0.08 | 0.16
22 | 1 | 33K |  | R METAL 33K 1% 1/2W | R1 | Stackpole Electronics Inc | CFM14JT33K0 | DigiKey | S33KQCT-ND | 0.08 | 0.08
23 | 4 | 10k |  | Resistance 1206 | R6, R8, R10, R15 | YAGEO | RC1206FR-0710KL | DigiKey | 311-10.0KFRCT-ND | 0.08 | 0.32
24 | 1 | 16k |  | Resistance 1206 | R19 | YAGEO | RC1206FR-0716KL | DigiKey | 311-16.0KFRCT-ND | 0.08 | 0.08
25 | 1 | 22k |  | Resistance 1206 | R7 | YAGEO | RC1206FR-0722KL | DigiKey | 311-22.0KFRCT-ND | 0.08 | 0.08
26 | 1 | 33k |  | Resistance 1206 | R16 | YAGEO | RC1206FR-0733KL | DigiKey | 311-33.0KFRCT-ND | 0.08 | 0.08
27 | 4 | 100k |  | Resistance 1206 | R5, R9, R11, R13 | YAGEO | RC1206FR-07100KL | DigiKey | 311-100KFRCT-ND | 0.08 | 0.32
28 | 1 | 270E |  | Resistance 1206 | R12 | Vishay Dale | CRCW1206270RJNEA | DigiKey | 541-270ECT-ND | 0.08 | 0.08
29 | 1 | 820k |  | Resistance 1206 | R14 | YAGEO | RC1206FR-07820KL | DigiKey | 311-820KFRCT-ND | 0.08 | 0.08
30 | 3 | Switch On-On |  | Switch on-on de côté | S1, S2, S3 | C&K | JS202011CQN | DigiKey | 401-2001-ND | 0.61 | 1.83
 |  |  |  |  |  |  |  |  | TOTAL |  | 98.81

Sheet: Sheet2
EMF
3.0
1
3.0.1
EMF 3.0.1
carte_electronique_didactique_PittetL02.BomDoc
TPI_PittetL02
EMF
carte_elec
#REF!
