PittetL02/tpi_carte_electronique_didactique_pittetl02/rpt/datasheet/Connecteurs/CT3151-2.STEP

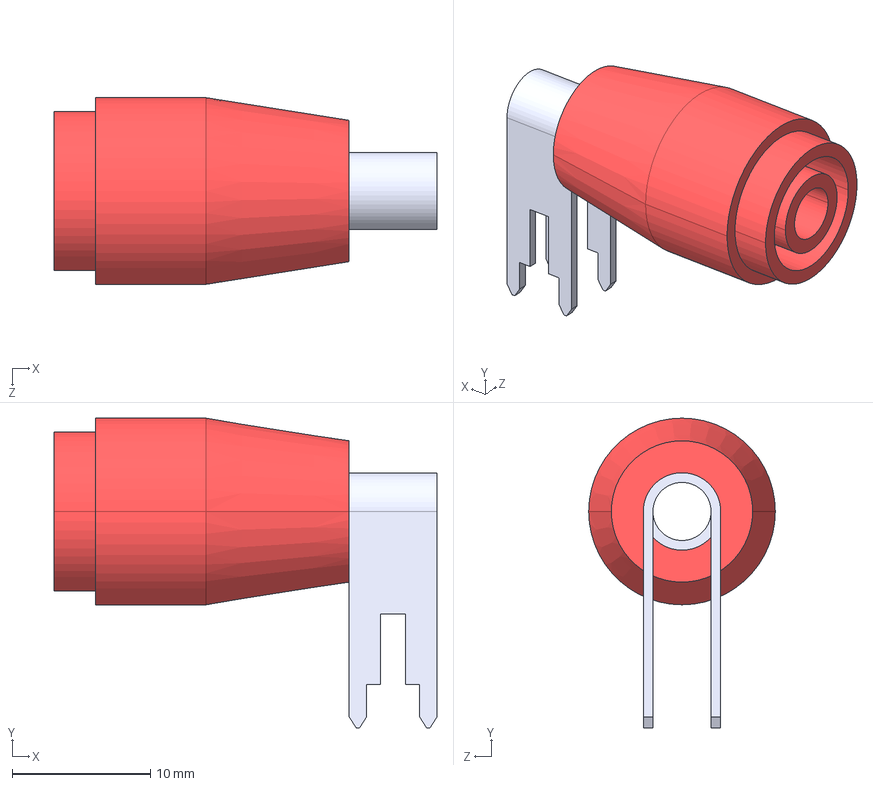
[picture p131: CAD file, 2025-05-19]
rpt/datasheet/Connecteurs/CT3151-2.STEP
27.7 x 22.4 x 13.5 mm
