PittetL02/tpi_carte_electronique_didactique_pittetl02/rpt/draw/logo/emf-logo-2018.dxf

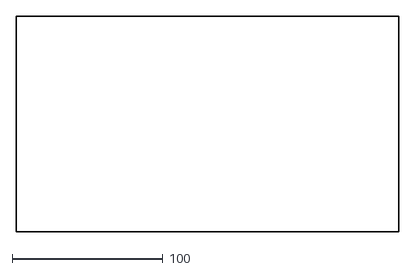
[picture p132: CAD file, 2025-05-12]
rpt/draw/logo/emf-logo-2018.dxf
254.0 x 142.9
