PittetL02/tpi_carte_electronique_didactique_pittetl02/rpt/Journal de travail/Journal_Travail_TPI_Semaine4_PittetL02.pdf

Journal de travail | Electronicien CFC | EMF-Industrie
Date | Projet | Thème | Action réalisée | Problème rencontré / Développement | Temps [H.h] | Report [H.h]
| Carte_electr onique_didac tique_Pittet L02 | Doc | Réalisation du Protocole de mise en service. | | 4.0
| | PCB | Modifications dernières erreures pour pouvoir commander une nouvelle version pour la présentation | | 3
[2025-06-02] | Total du jour > | 7.0
Carte_electr
onique_didac
tique_Pittet
L02
Doc | Remplissage rpt de
travail et de
développement
| | 7.0
[2025-06-03] | Total du jour > | 7.0
Carte_electr
onique_didac
tique_Pittet
L02
Doc | Remplissage rpt de
travail, de
développement et de
l'arboréscence | 7.0
[2025-06-04] | Total du jour > | 7.0

### Pittet Loïc

lundi

mardi

mercredi

| Total du jour > | 0.0

vendredi
| | Total du jour > | 0.0
Auto-évaluation personnelle hebdomadaire ↓↓↓ | Total de la semaine > | 21.0
Fin du projet. J'ai réussi à le mener au bout. Cette dernière semaine a été très documentative. J'ai mis à jour toute l'arboréscence avec l'ajout de toutes mes prises de notes. J'ai terminé mon rapport de développement ainsi que de travail. J'ai fait en sorte de rendre tous les documents.

jeudi
