PittetL02/tpi_carte_electronique_didactique_pittetl02/pcb/pdf/MEC/V3.0.1/carte_electronique_didactique_PittetL02_MEC.pdf

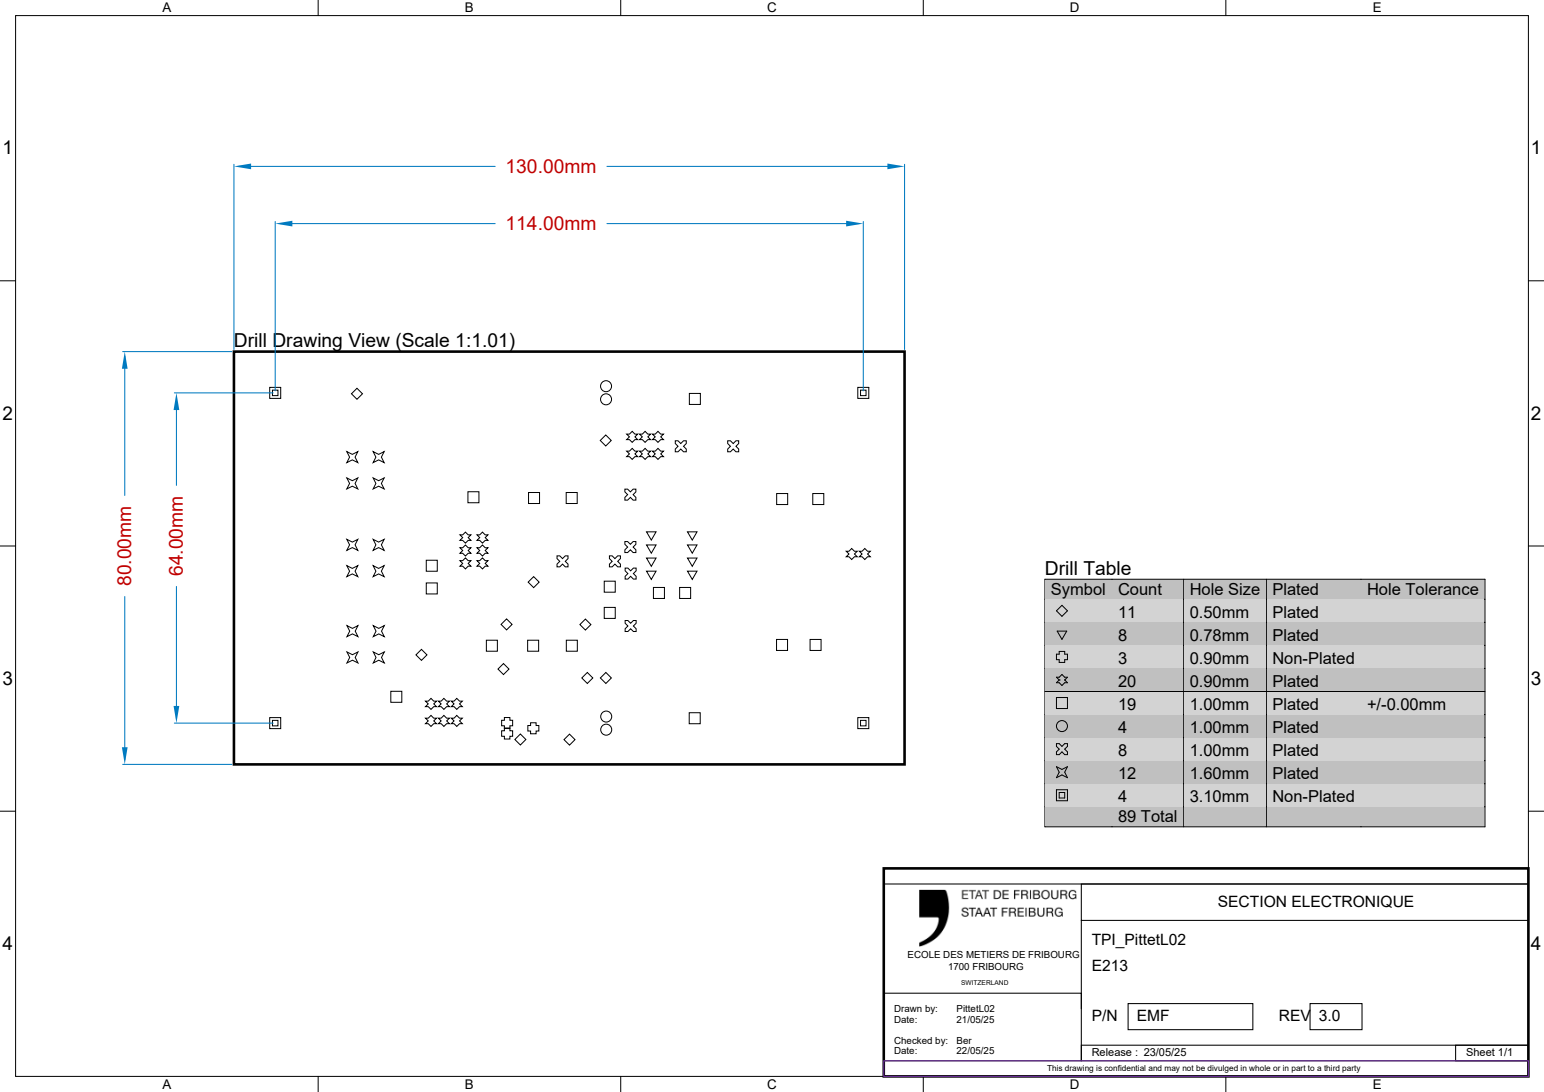
[picture p133: page 1]
Drill Table; Sheet 1/1; Date:; EMF; Drawn by:; Ber; TPI_PittetL02; REV; PittetL02; Release : 23/05/25; Checked by:; SECTION ELECTRONIQUE; 1700 FRIBOURG; SWITZERLAND

Drill Drawing View (Scale 1:1.01)

Symbol | Count | Hole Size | Plated | Hole Tolerance

11 | 0.50mm | Plated
8 | 0.78mm | Plated
3 | 0.90mm | Non-Plated
20 | 0.90mm | Plated
19 | 1.00mm | Plated | +/-0.00mm
4 | 1.00mm | Plated
8 | 1.00mm | Plated
12 | 1.60mm | Plated
4 | 3.10mm | Non-Plated
89 Total

ECOLE DES METIERS DE FRIBOURG

This drawing is confidential and may not be divulged in whole or in part to a third party
