PittetL02/tpi_carte_electronique_didactique_pittetl02/pcb/pdf/EQU/V2.0.2/carte_electronique_didactique_PittetL02_EQU.pdf

A

B

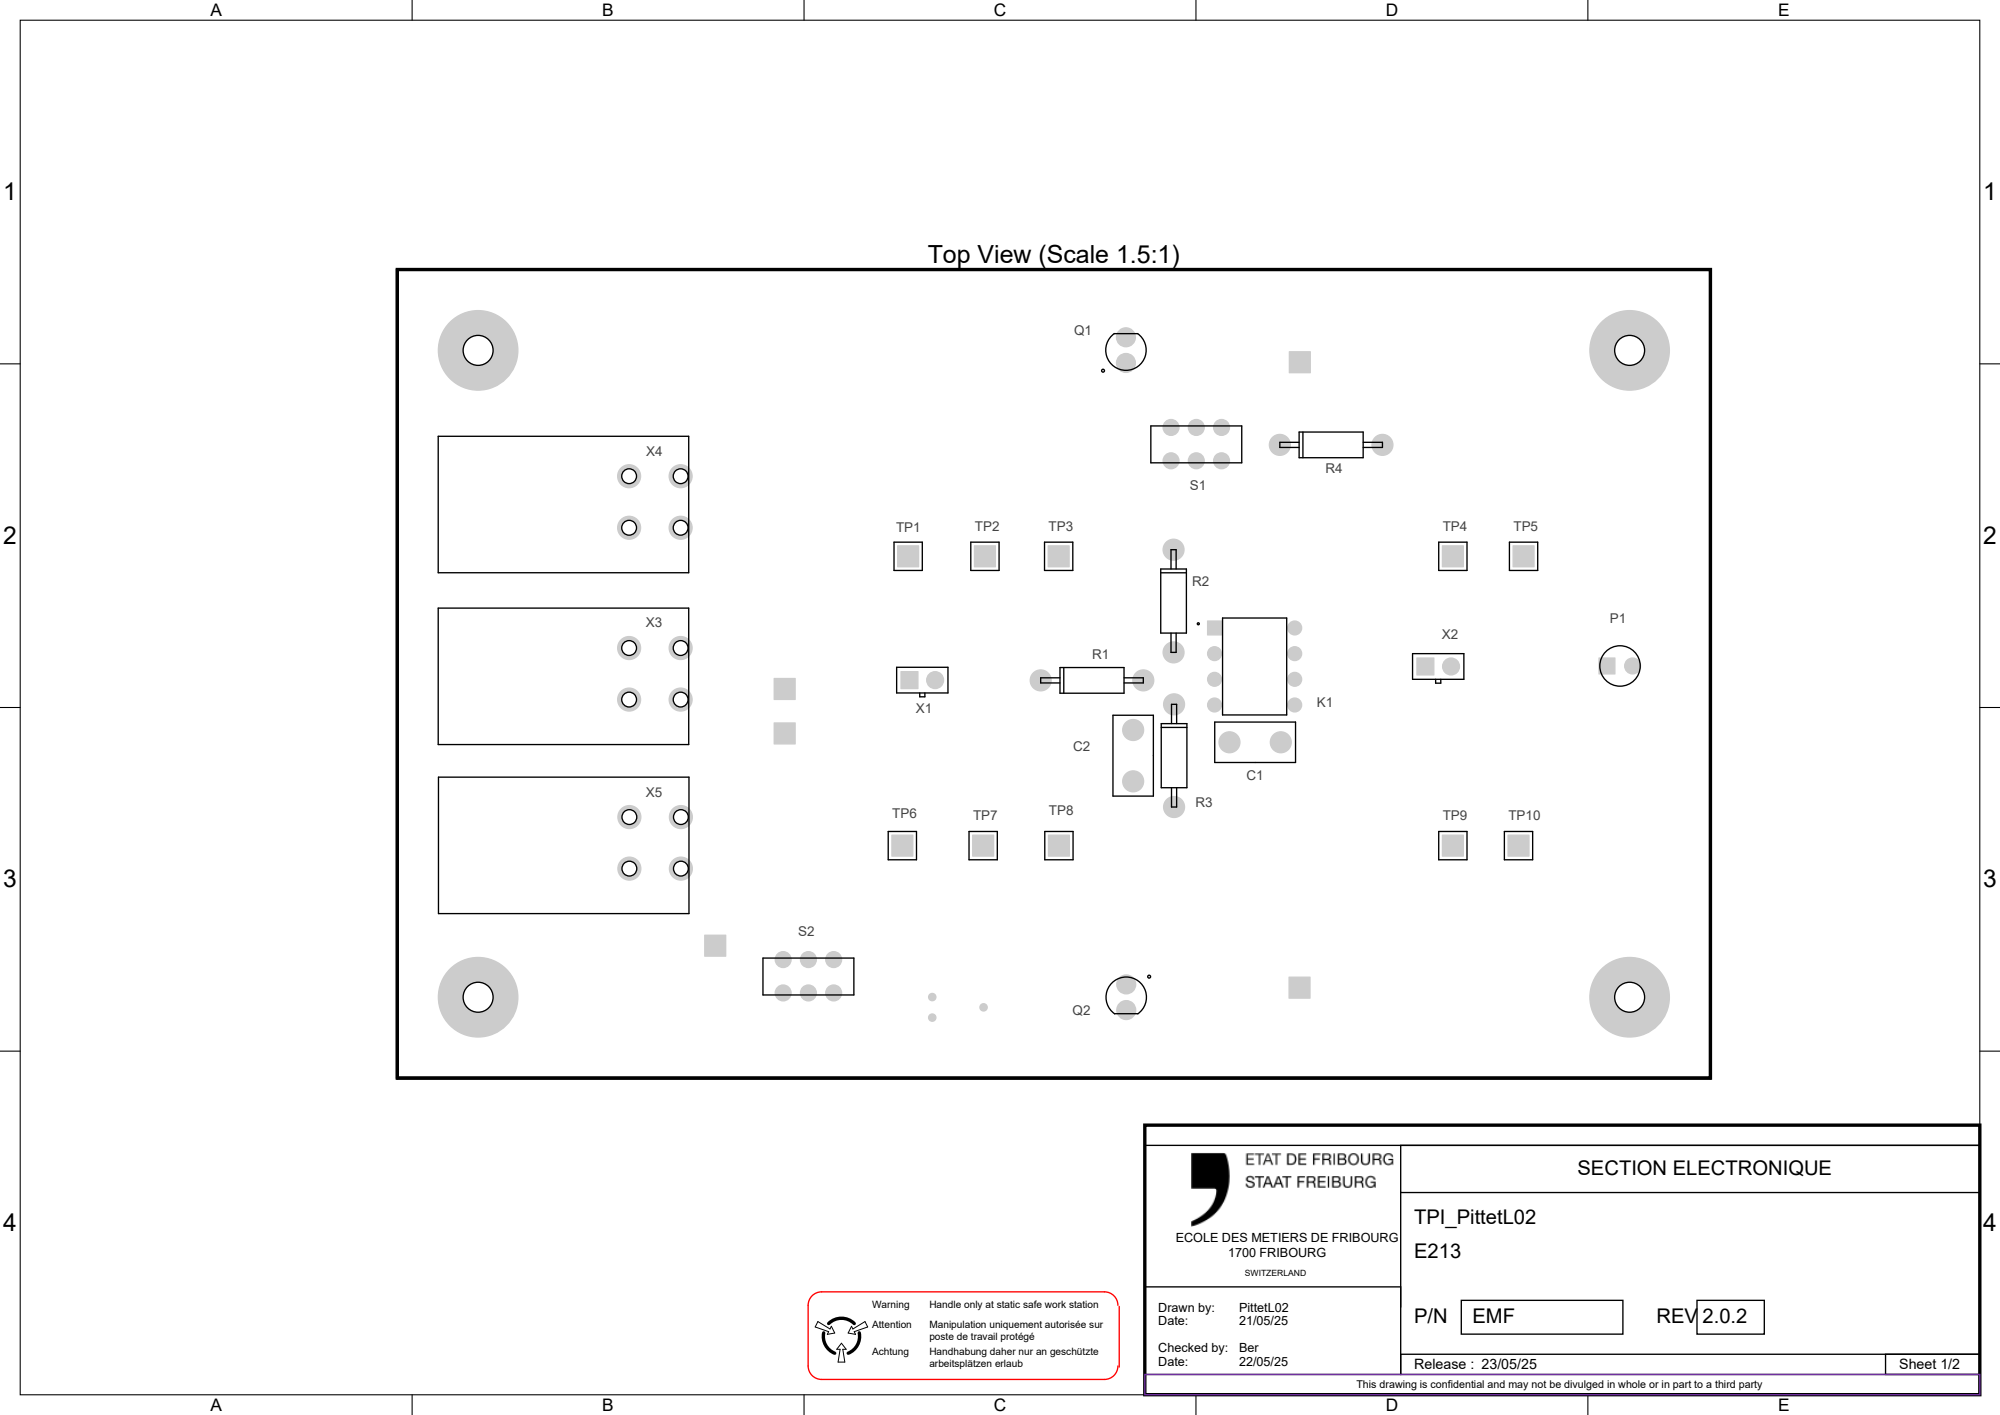
[picture p136: page 1]

ECOLE DES METIERS DE FRIBOURG

Manipulation uniquement autorisée sur
poste de travail protégé
Handhabung daher nur an geschützte
arbeitsplätzen erlaub

This drawing is confidential and may not be divulged in whole or in part to a third party

A

B

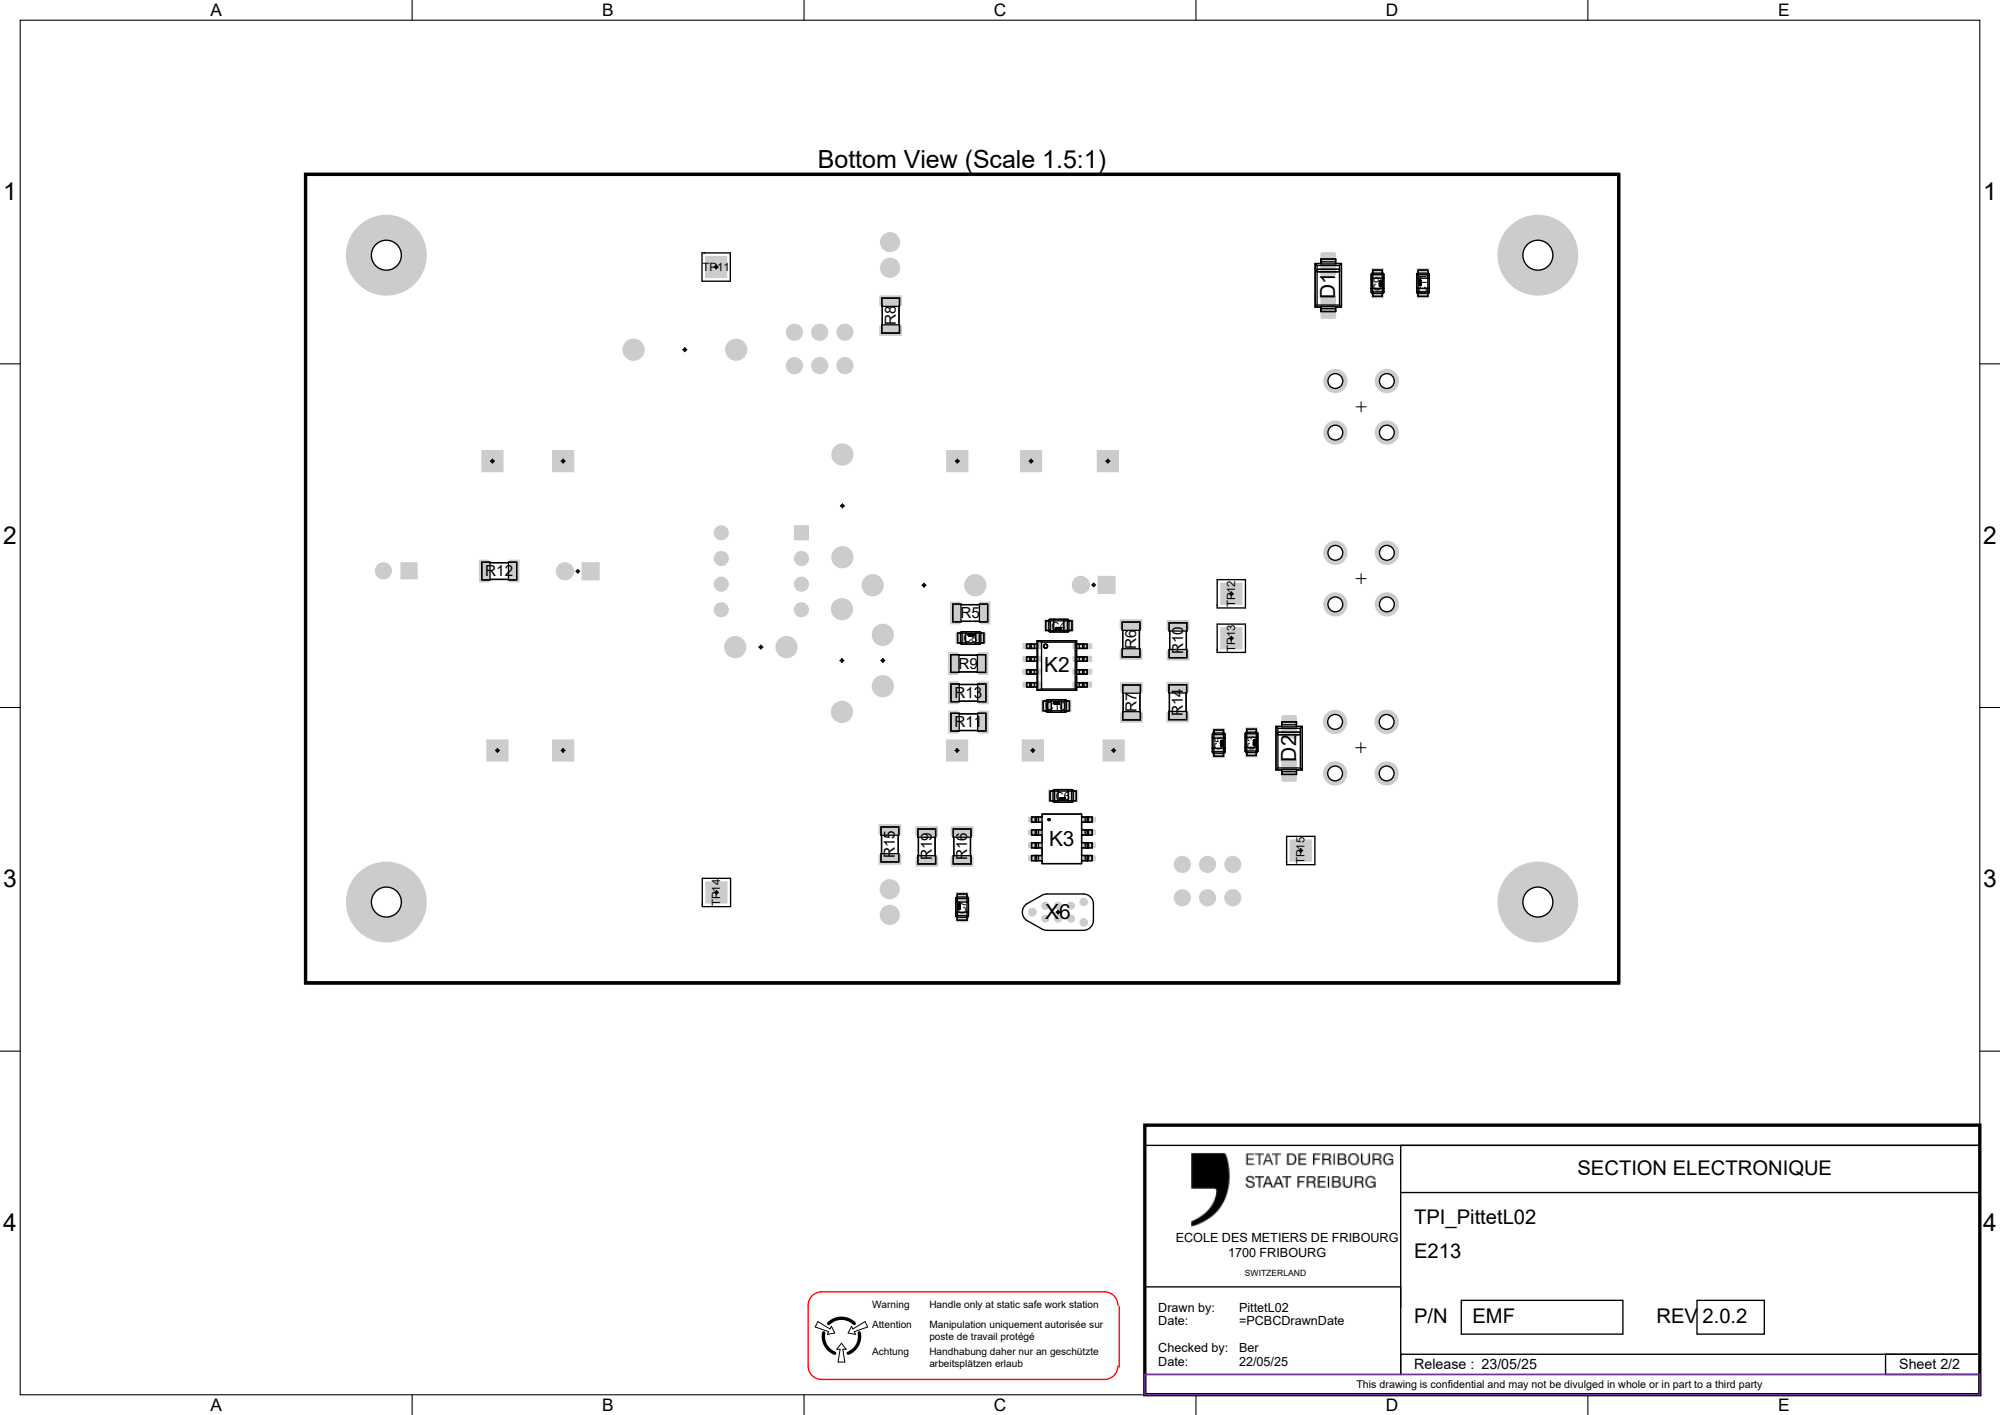
[picture p137: page 2]

ECOLE DES METIERS DE FRIBOURG

Manipulation uniquement autorisée sur
poste de travail protégé
Handhabung daher nur an geschützte
arbeitsplätzen erlaub

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
