PittetL02/tpi_carte_electronique_didactique_pittetl02/(list of files, drawings)

Other design files:
pcb/carte_electronique_didactique_PittetL02_PCB.PcbDoc
pcb/carte_electronique_didactique_PittetL02_Project.PrjPcb
pcb/carte_electronique_didactique_PittetL02_SCH.SchDoc
