PittetL02/tpi_carte_electronique_didactique_pittetl02/(commit log)

2025-05-12 Création du projet
    Arborescence et renommage des fichiers
    [A faire pour TPI Pittet.xlsx, Carte_electronique_didactique_PittetL02-rpt-journal.xlsx, carte_electronique_didactique_PittetL02-rpt-journal-Pittet.xlsx, carte_electronique_didactique_PittetL02_PCB.PcbDoc, carte_electronique_didactique_PittetL02_Project.PrjPcb, emf-logo-2018.dxf]
2025-05-12 Fin première journée
    Création d'un premier schéma bloc.
    Rapport de journal.
    Recherches sur plusieurs façons de créer du bruit à l'aide d'un PIC
    [A faire pour TPI Pittet.xlsx, Carte_electronique_didactique_PittetL02-rpt-journal.xlsx, carte_electronique_didactique_PittetL02-rpt-journal-Pittet.xlsx, carte_electronique_didactique_PittetL02-rpt-journal.xlsx, projectname-xxx-rpt-journal.xlsx]
2025-05-13 Fin 2ème journée
    Recherches pour inverser l'état de la Led.
    Tests d'une LDR et d'un photo-resistor.
    Ajout du schéma bloc.
    Recherche de composants.
    [carte_electronique_didactique_PittetL02-rpt-journal.xlsx]
2025-05-14 Fin 3ème journée
    Discussion avec Mr.Berset
    Tests sur plaque d'expérimentation.
    [carte_electronique_didactique_PittetL02-rpt-journal.xlsx]
2025-05-16 Fin 4ème journée
    Création de schéma-bloc au propre
    Création du firmware pour la création de bruit depuis le PIC
    Création d'un fichier pour les composants
    Ajout de datasheet
    [Liste_Composants1.xlsx, carte_electronique_didactique_PittetL02-rpt-journal.xlsx]
2025-05-16 Fin première semaine
    Création d'une simulation TINA
    Début projet Altium
    Journal de travail
    Test plaque d'essais
    [carte_electronique_didactique_PittetL02-rpt-journal.xlsx, carte_electronique_didactique_PittetL02_Project.PrjPcb, carte_electronique_didactique_PittetL02_SCH.SchDoc]
2025-05-19 Fin jour 6
    Finalisation du schéma Altium
    Test Tina avec nouveau capteur
    Test plaque d'expérimentation avec nouveau capteur
    Création de la BOM
    Ajout des empreintes et empreintes 3D
    Ajout de Datasheet
    [CT3151-2.STEP, carte_electronique_didactique_PittetL02-rpt-journal.xlsx, carte_electronique_didactique_PittetL02_PCB.PcbDoc, carte_electronique_didactique_PittetL02_Project.PrjPcb, carte_electronique_didactique_PittetL02_SCH.SchDoc]
2025-05-20 Fin 7ème journée
    Layout terminé
    Modification de schéma
    Discussion avec experts
    [carte_electronique_didactique_PittetL02-rpt-journal.xlsx, carte_electronique_didactique_PittetL02_PCB.PcbDoc, carte_electronique_didactique_PittetL02_Project.PrjPcb, carte_electronique_didactique_PittetL02_SCH.SchDoc]
2025-05-21 Fin 8ème journée
    Layout amélioré.
    Modification de la schematic.
    Ecriture du rapport de développement.
    [carte_electronique_didactique_PittetL02-rpt-journal.xlsx, carte_electronique_didactique_PittetL02_PCB.PcbDoc, carte_electronique_didactique_PittetL02_Project.PrjPcb, carte_electronique_didactique_PittetL02_Project.xlsx, carte_electronique_didactique_PittetL02_SCH.SchDoc]
2025-05-23 Commande PCB
    Fichiers gerbers,
    Commande du PCB
    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
    [carte_electronique_didactique_PittetL02-rpt-journal.xlsx, carte_electronique_didactique_PittetL02_BOM.xlsx, carte_electronique_didactique_PittetL02_PCB.PcbDoc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]
2025-05-23 V2.0.1
    Correction d'une erreur sur le schéma et sur le layout.
    Rpt de dev
    Firmware pour nouveau PIC
    [carte_electronique_didactique_PittetL02-rpt-journal.xlsx, carte_electronique_didactique_PittetL02_BOM.xlsx, carte_electronique_didactique_PittetL02_PCB.PcbDoc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]
2025-05-26 FIn 11ème journée
    Rpt de dév
    Rpt de travail
    Protocole de mise en service
    [carte_electronique_didactique_PittetL02-rpt-journal.xlsx, carte_electronique_didactique_PittetL02_BOM.xlsx, carte_electronique_didactique_PittetL02_SCH.SchDoc]
2025-05-28 Réception PCB
    Montage d'une partie du pcb
    Optimisation Code
    Rapport de travail et de développement
    [carte_electronique_didactique_PittetL02-rpt-journal.xlsx, carte_electronique_didactique_PittetL02_SCH.SchDoc]
2025-06-03 V2.0.2
    Commande version 2.0.2
    Ajout documents dans le répertoire
    [A faire pour TPI Pittet.xlsx, carte_electronique_didactique_PittetL02-rpt-journal.xlsx, carte_electronique_didactique_PittetL02_PCB.PcbDoc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]
2025-06-04 Rendu du projet V2.0.2
    Rendu des fichiers de fabrications, des rapports ainsi que de toute l'arborescence complète
    [Liste_Composants1.xlsx, carte_electronique_didactique_PittetL02-rpt-journal.xlsx, carte_electronique_didactique_PittetL02_BOM.xlsx, carte_electronique_didactique_PittetL02_PCB.PcbDoc, carte_electronique_didactique_PittetL02_Project.PrjPcb, carte_electronique_didactique_PittetL02_Project.xlsx, carte_electronique_didactique_PittetL02_SCH.SchDoc]
